Ansel84/BMW_E30_SI_Board/KiCad Projects/BMW E30 VFL SI Board V2/BMW_E30_VFL_SI_Board_Schematic_V2.1.pdf

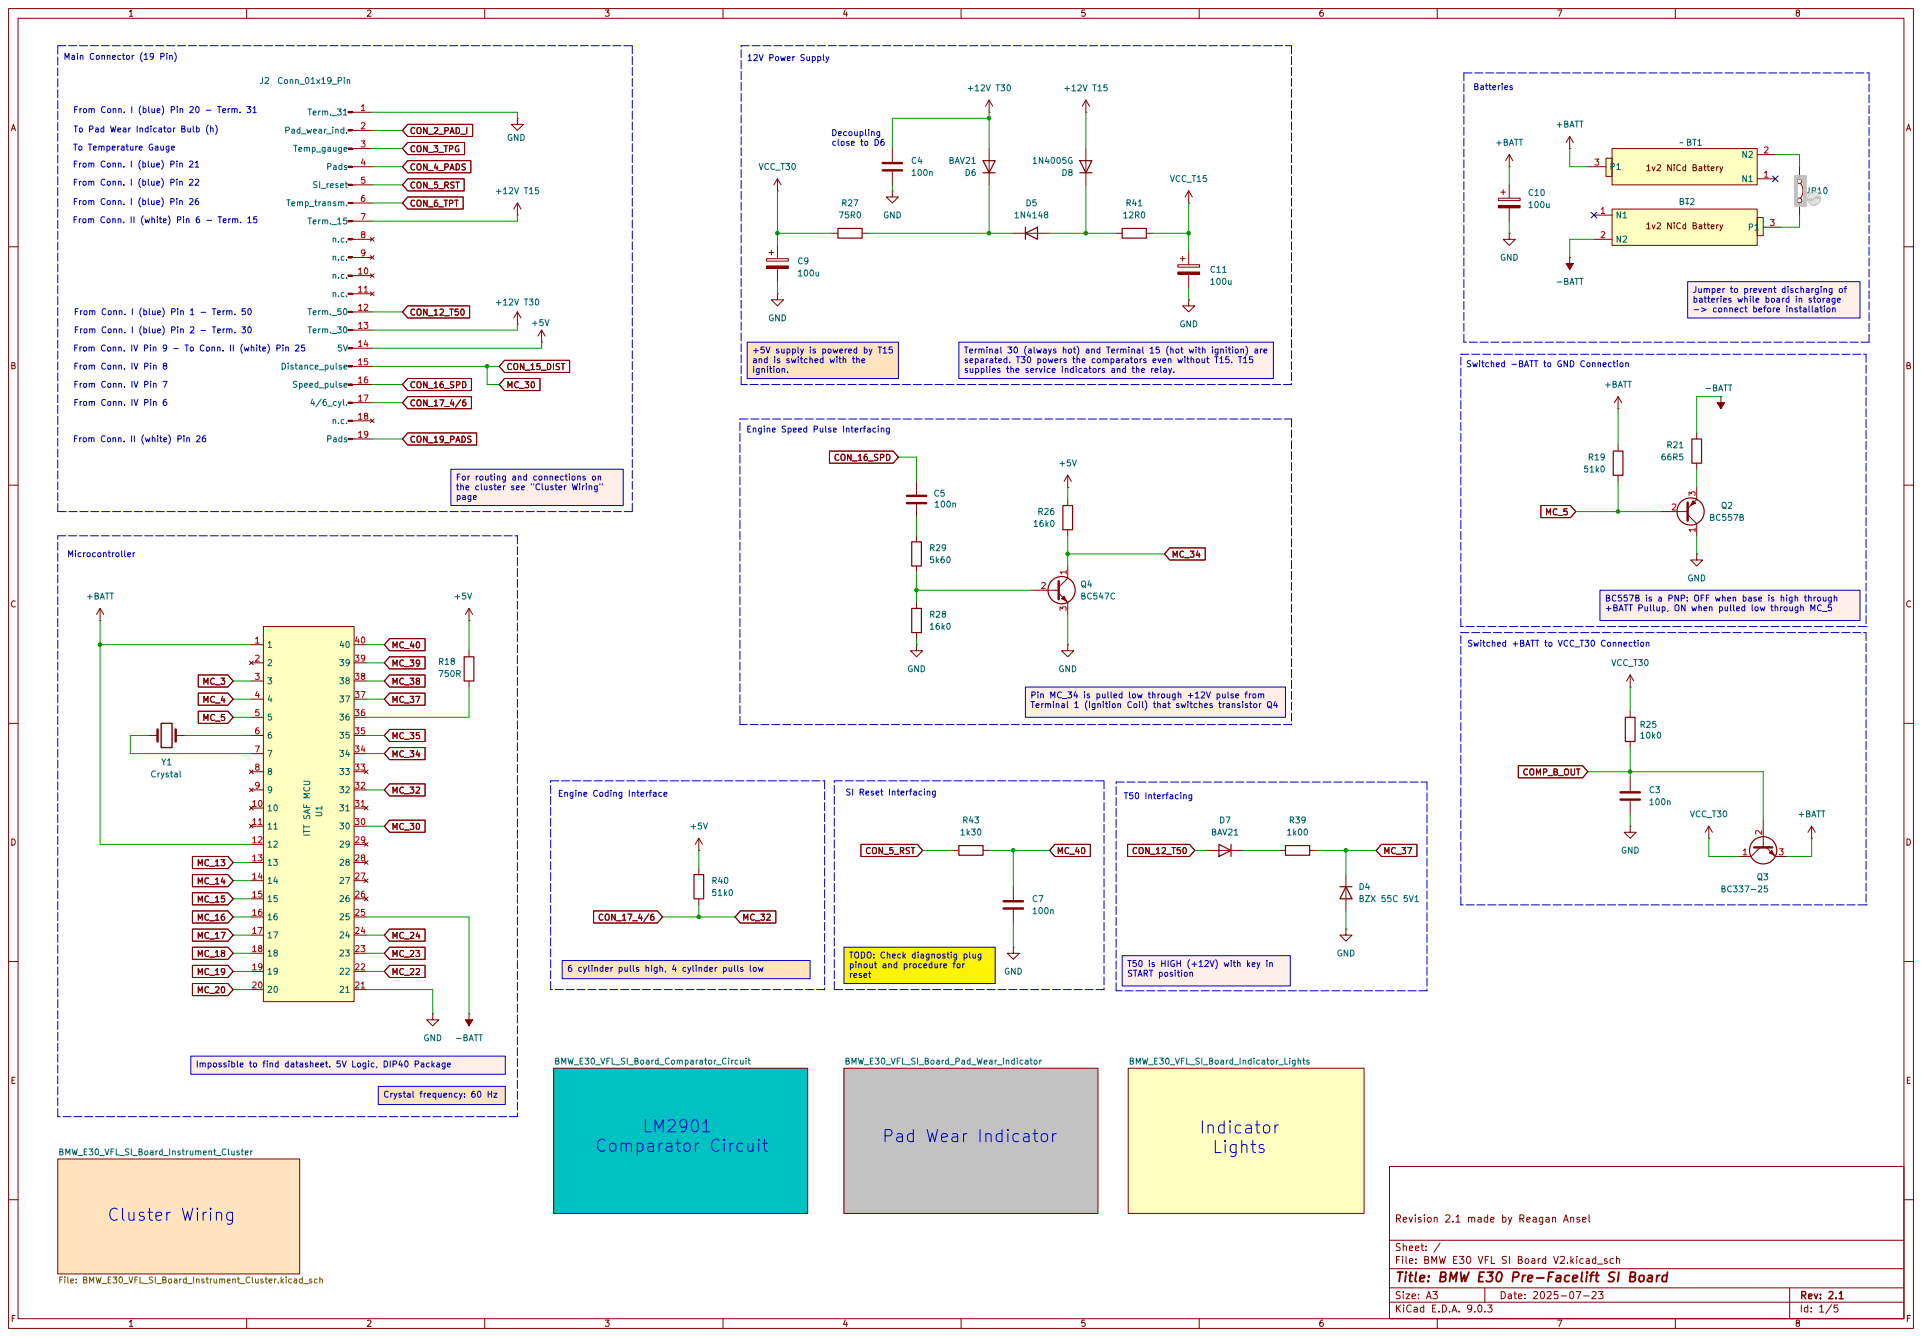
[picture p1: page 1]

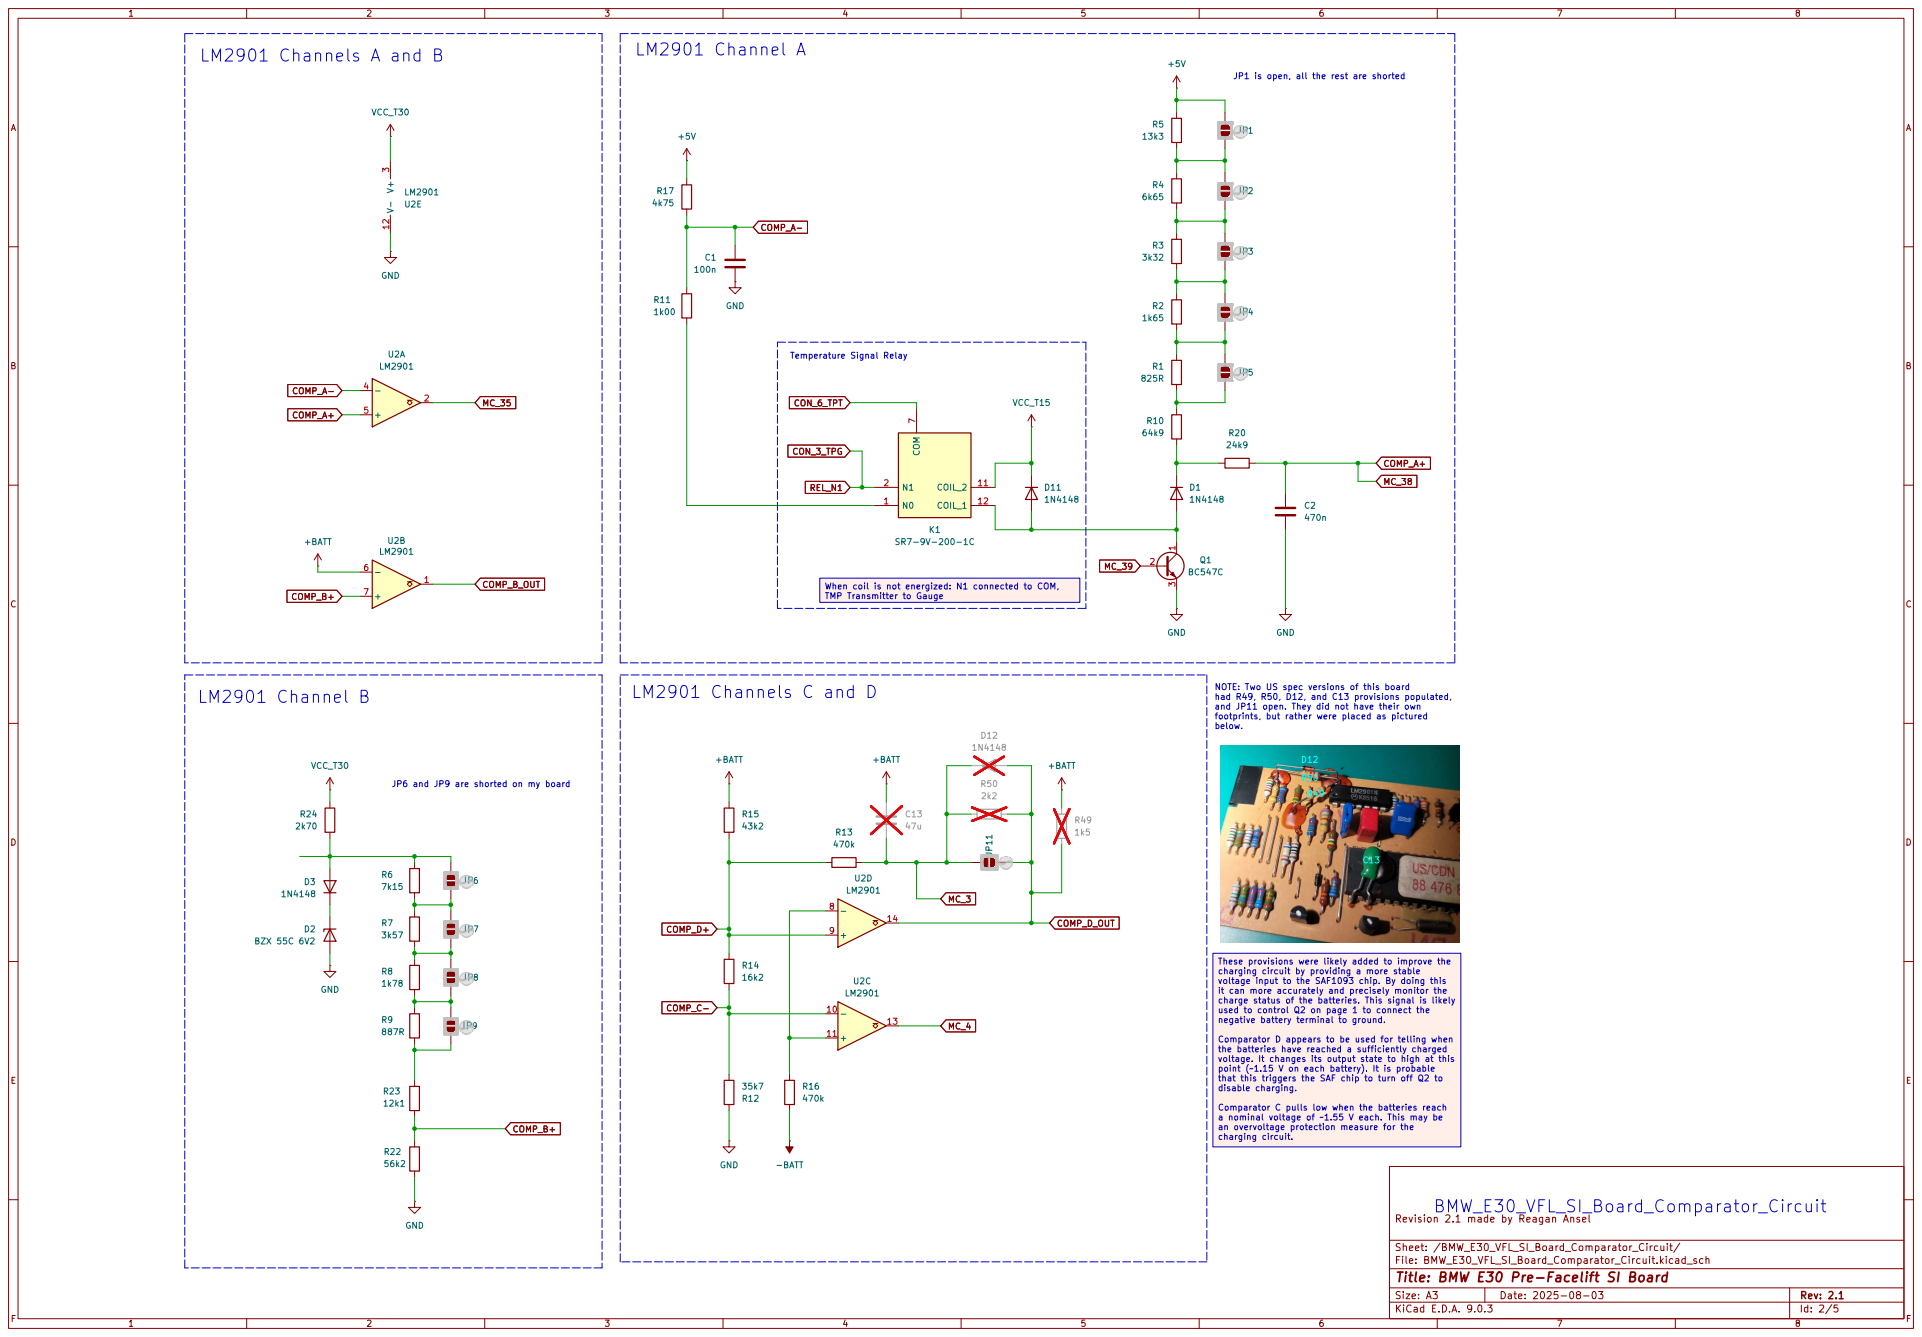
[picture p2: page 2]

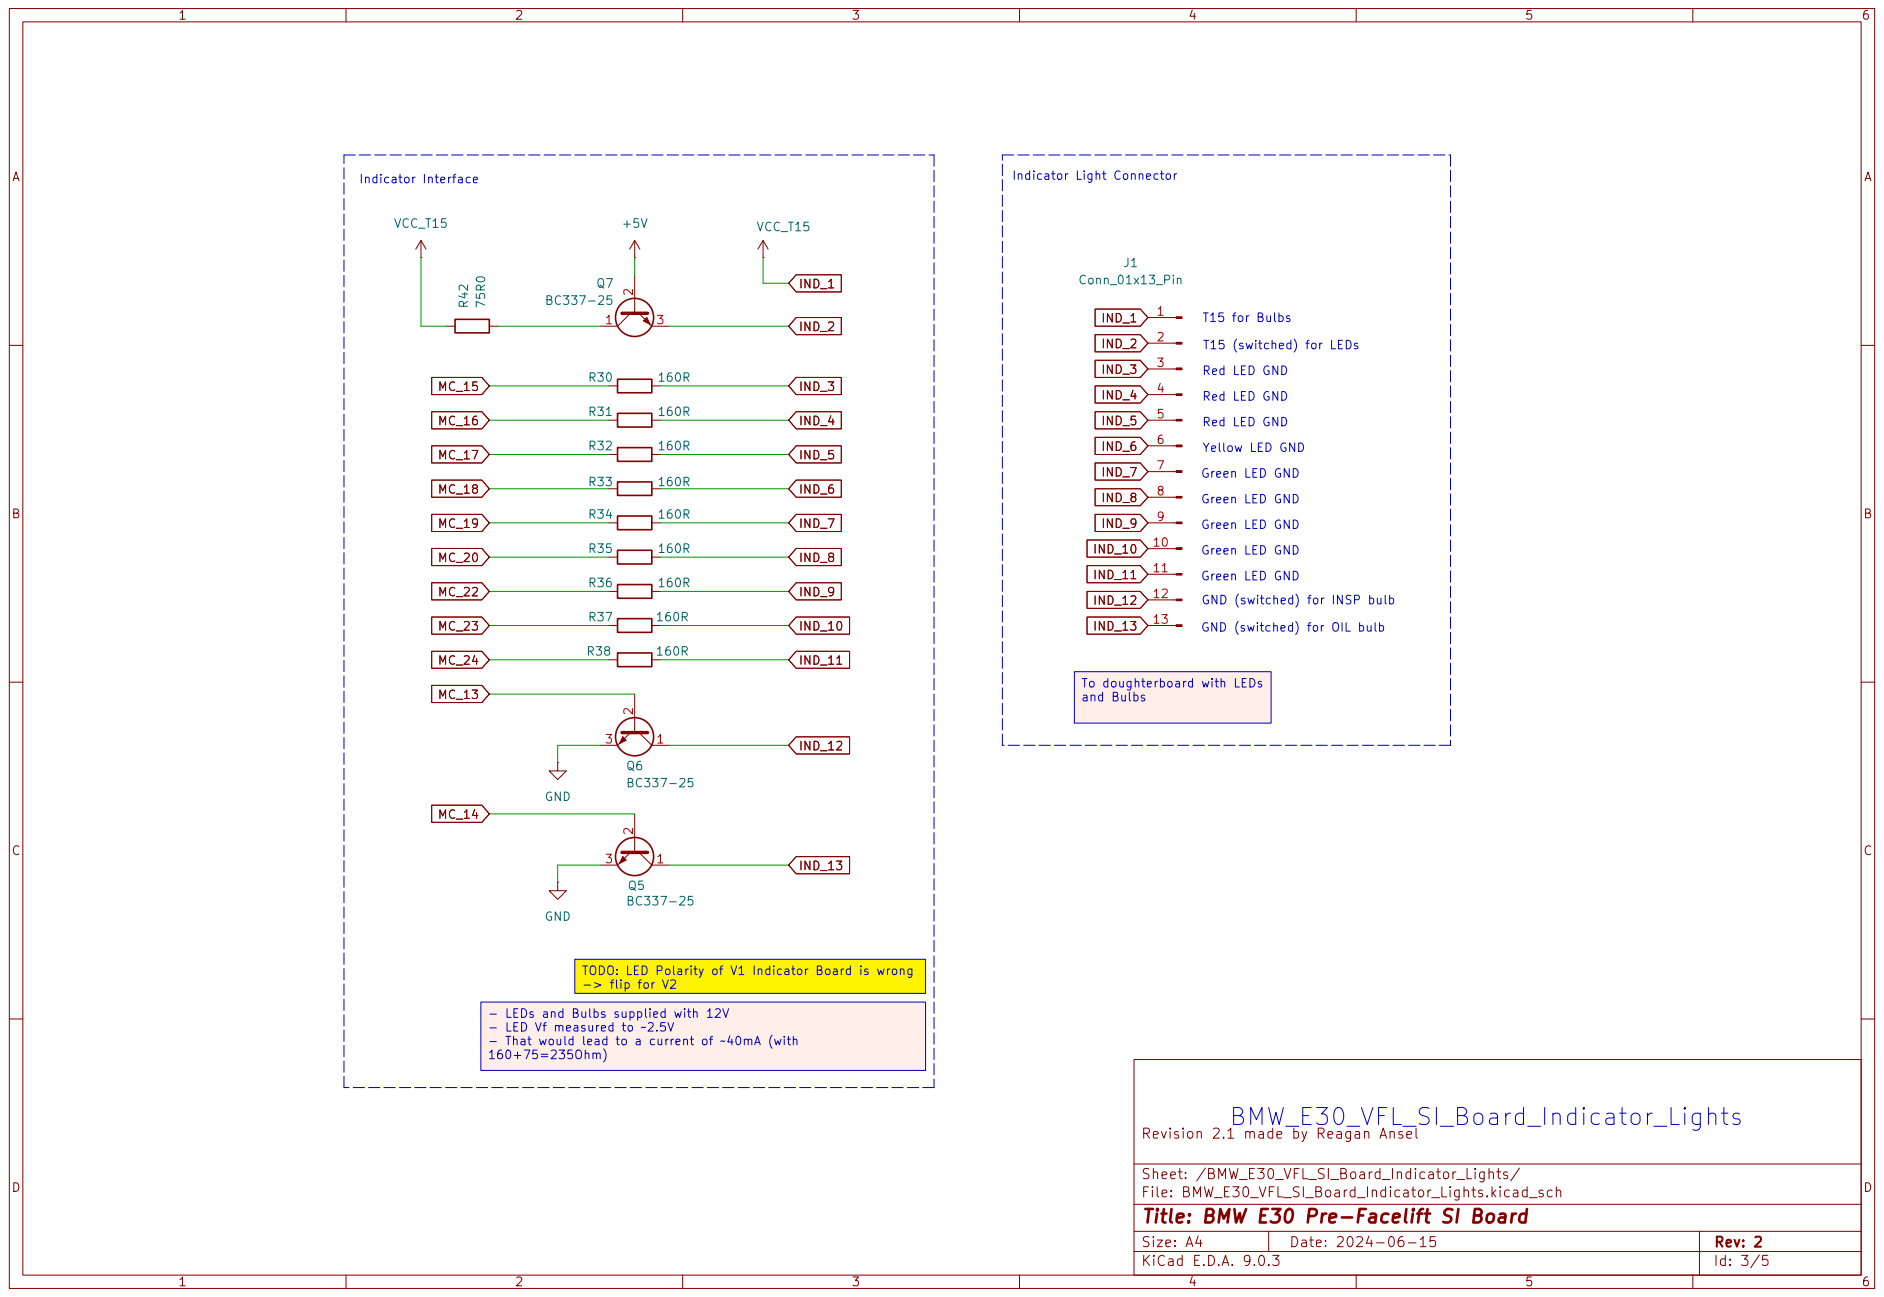
[picture p3: page 3]

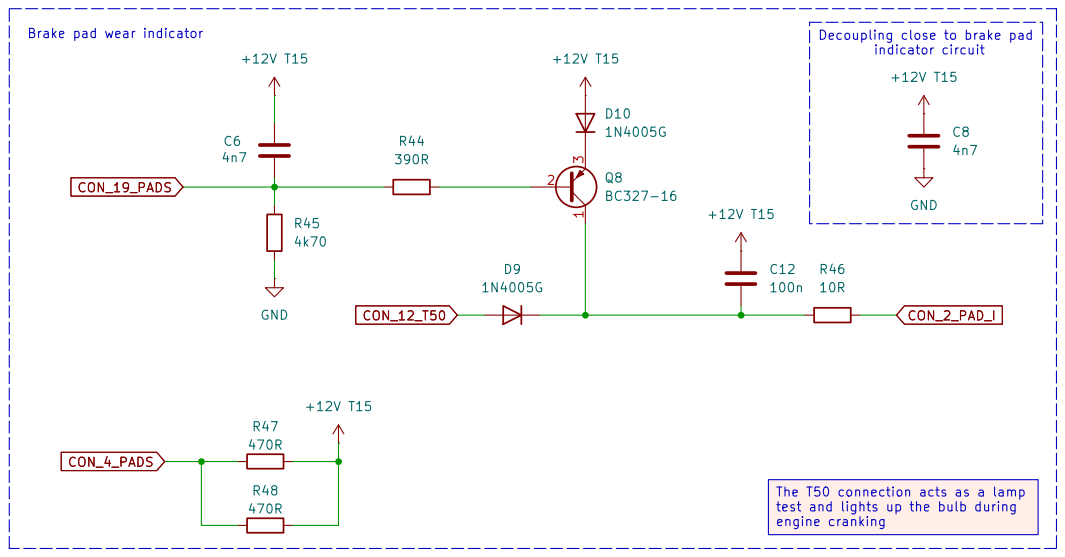
[picture p4: page 4]

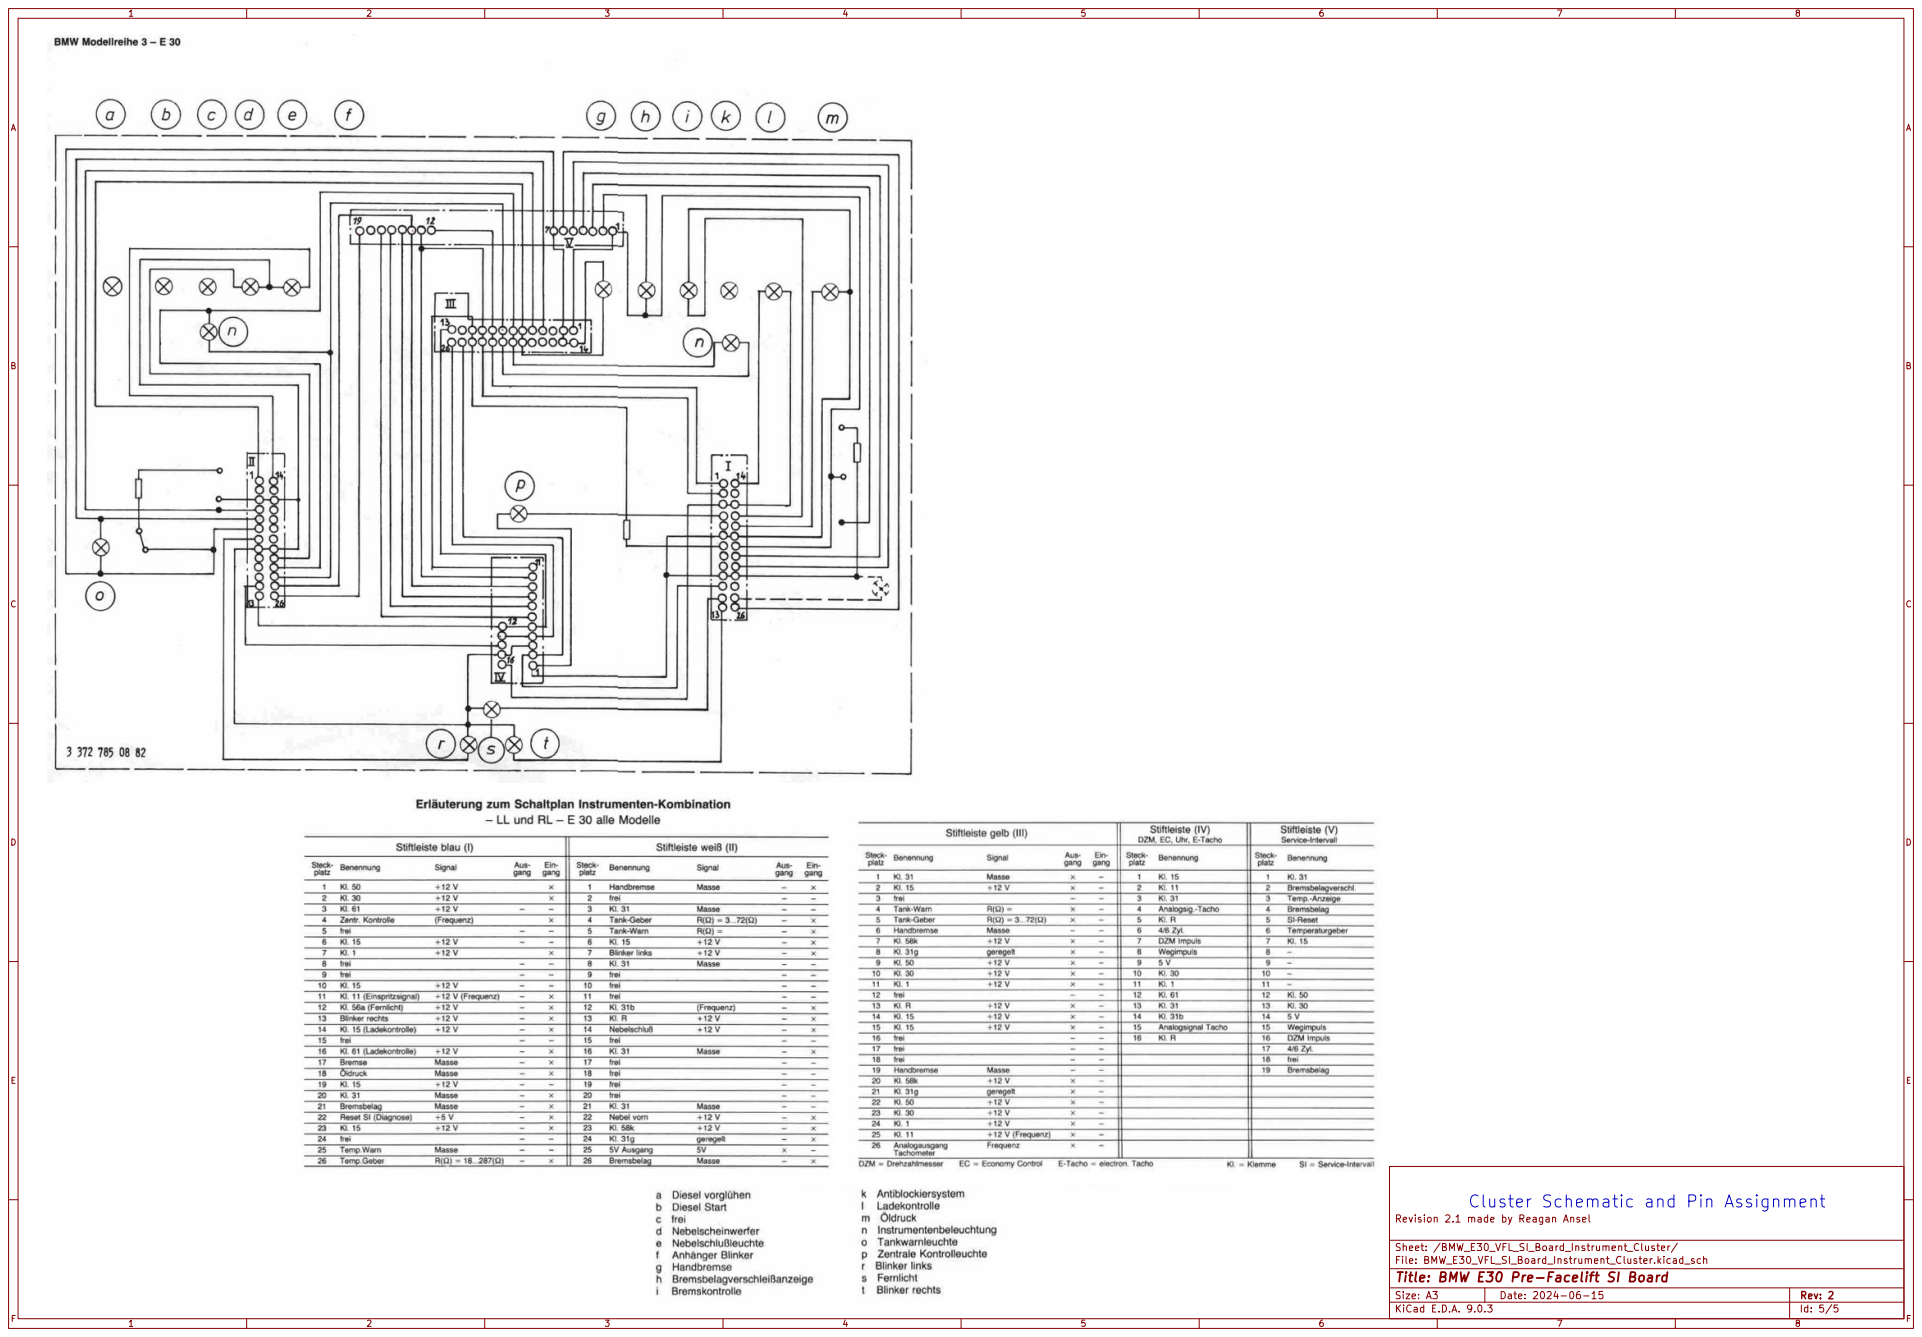
[picture p5: page 5]
