Ansel84/BMW_E30_SI_Board/KiCad Projects/BMW E30 VFL SI Board V2/BMW_E30_VFL_SI_Board_Schematic_V2.pdf

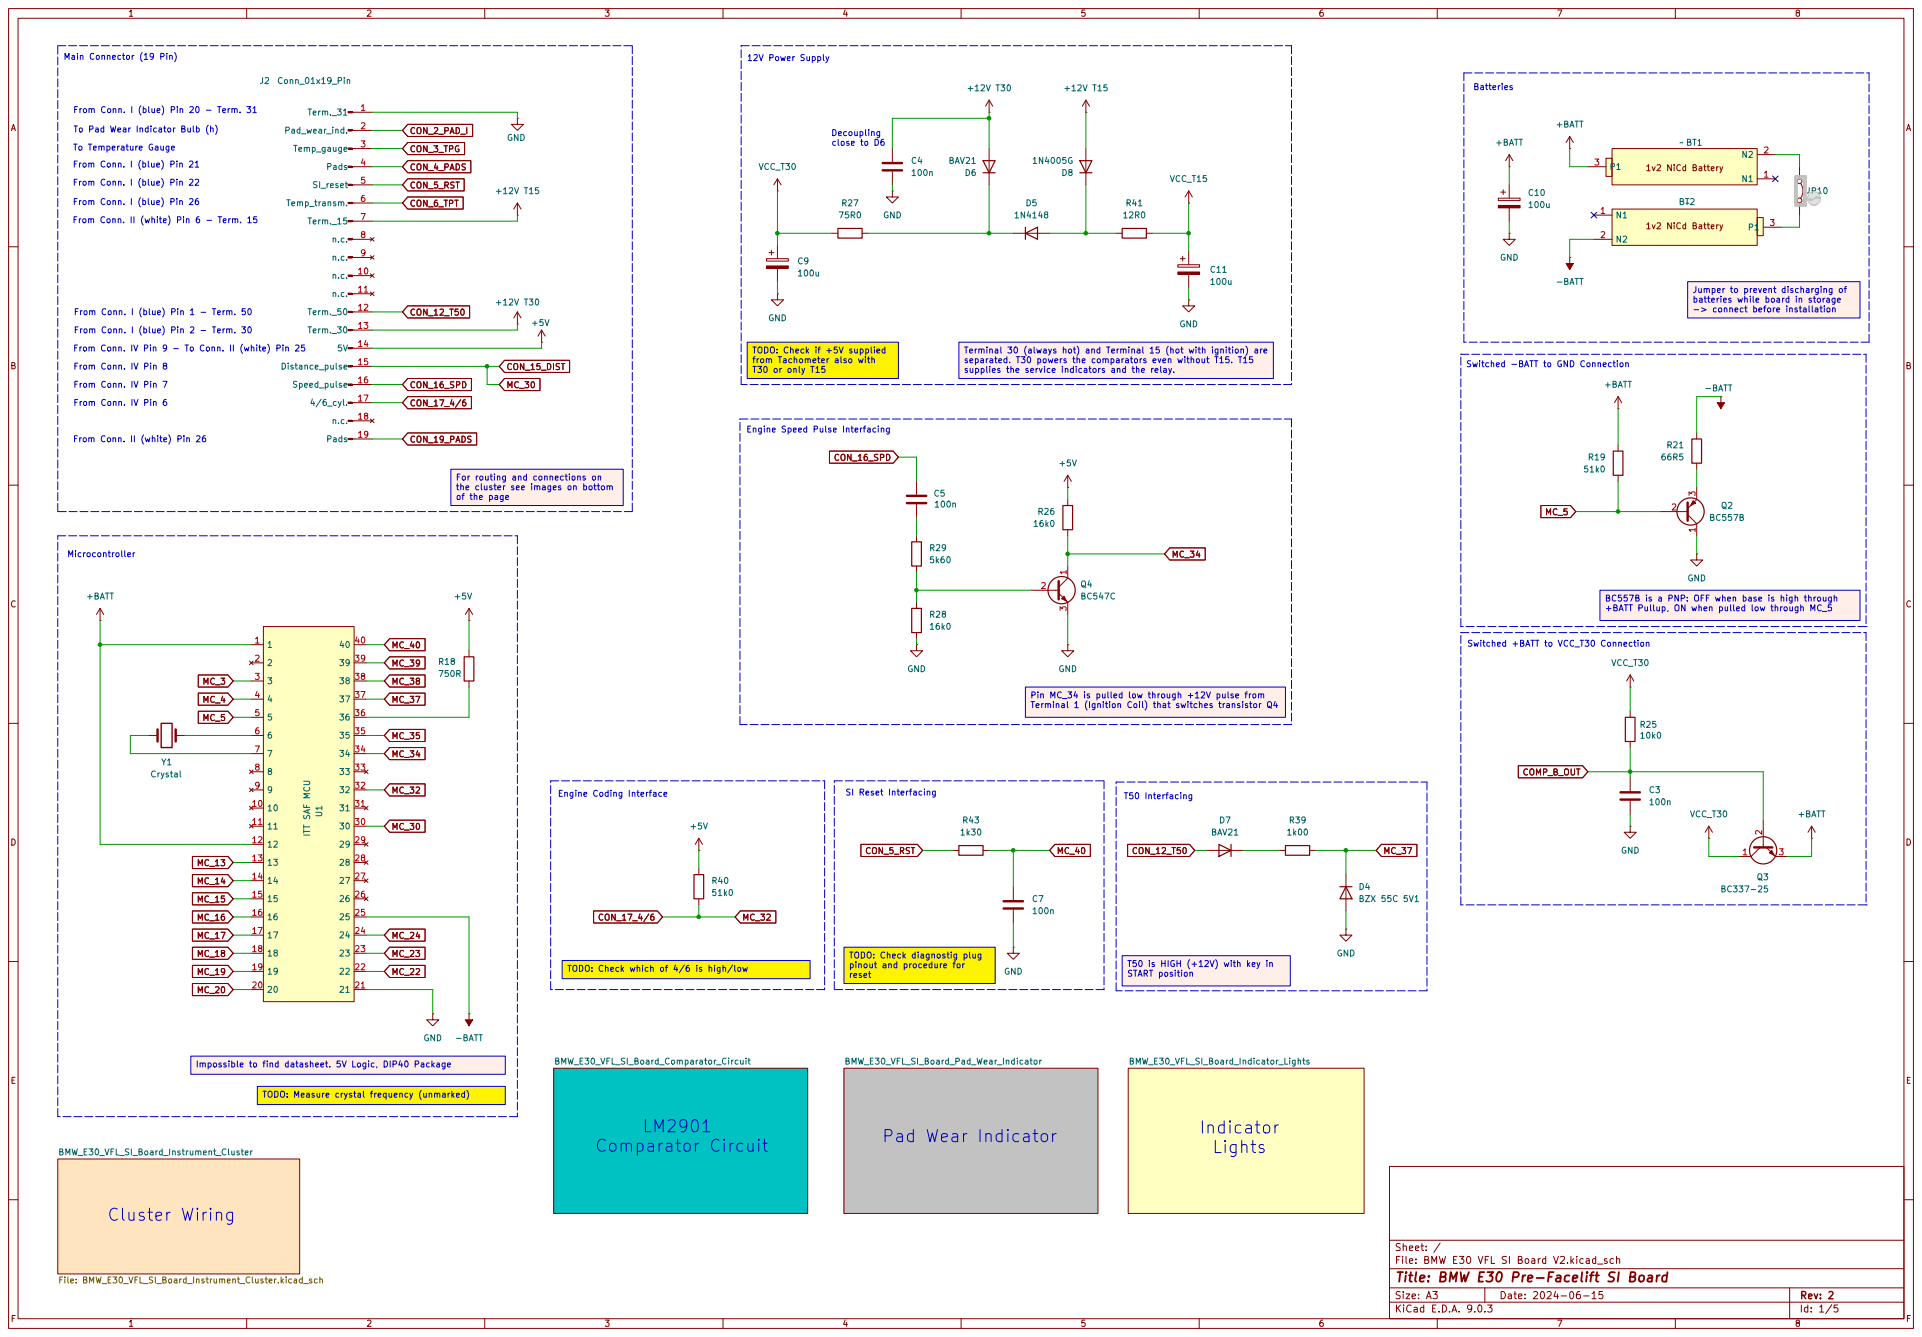
[picture p6: page 1]

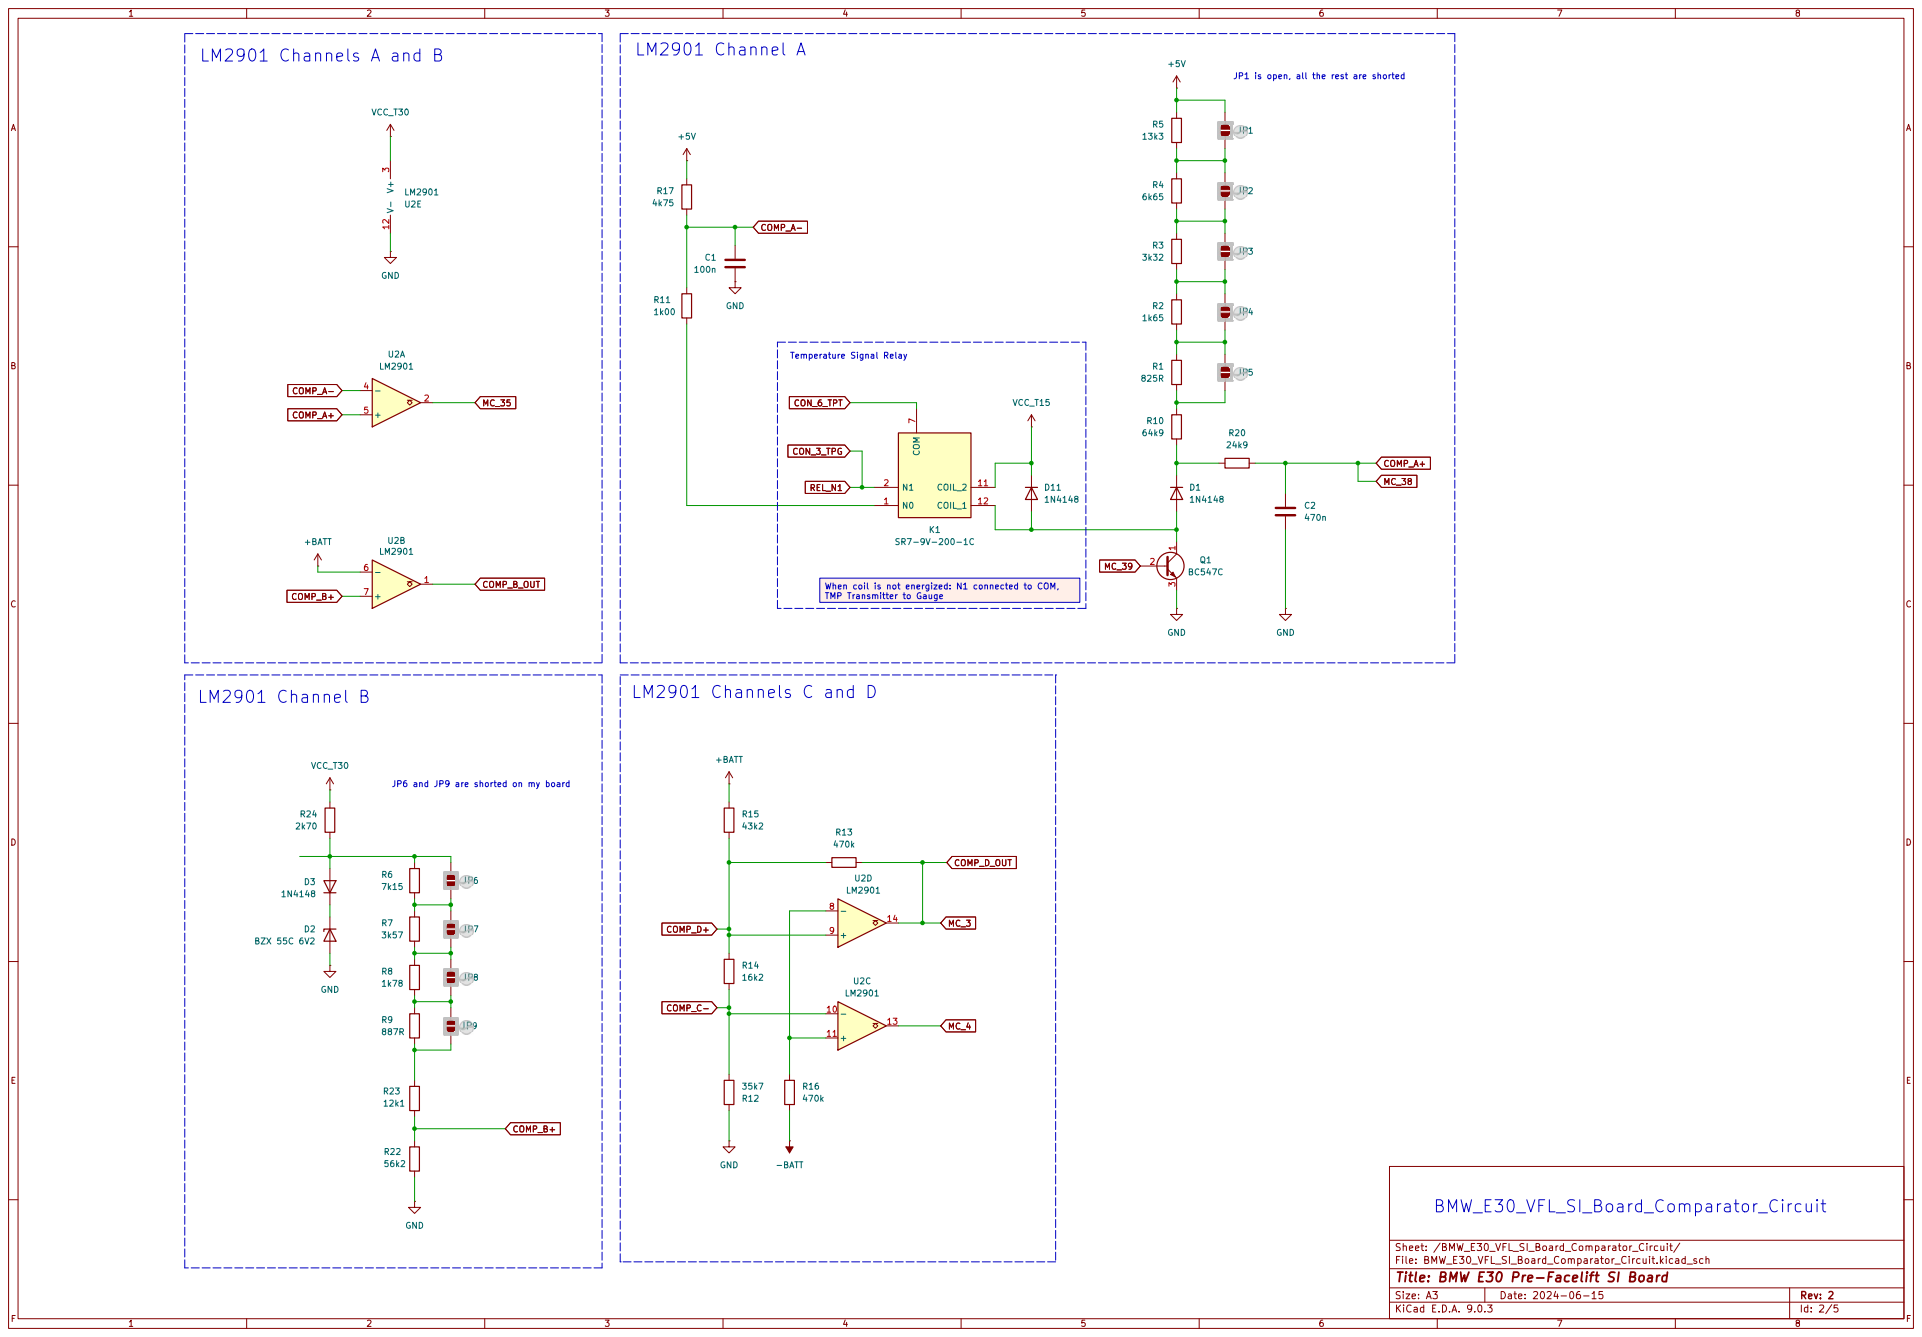
[picture p7: page 2]

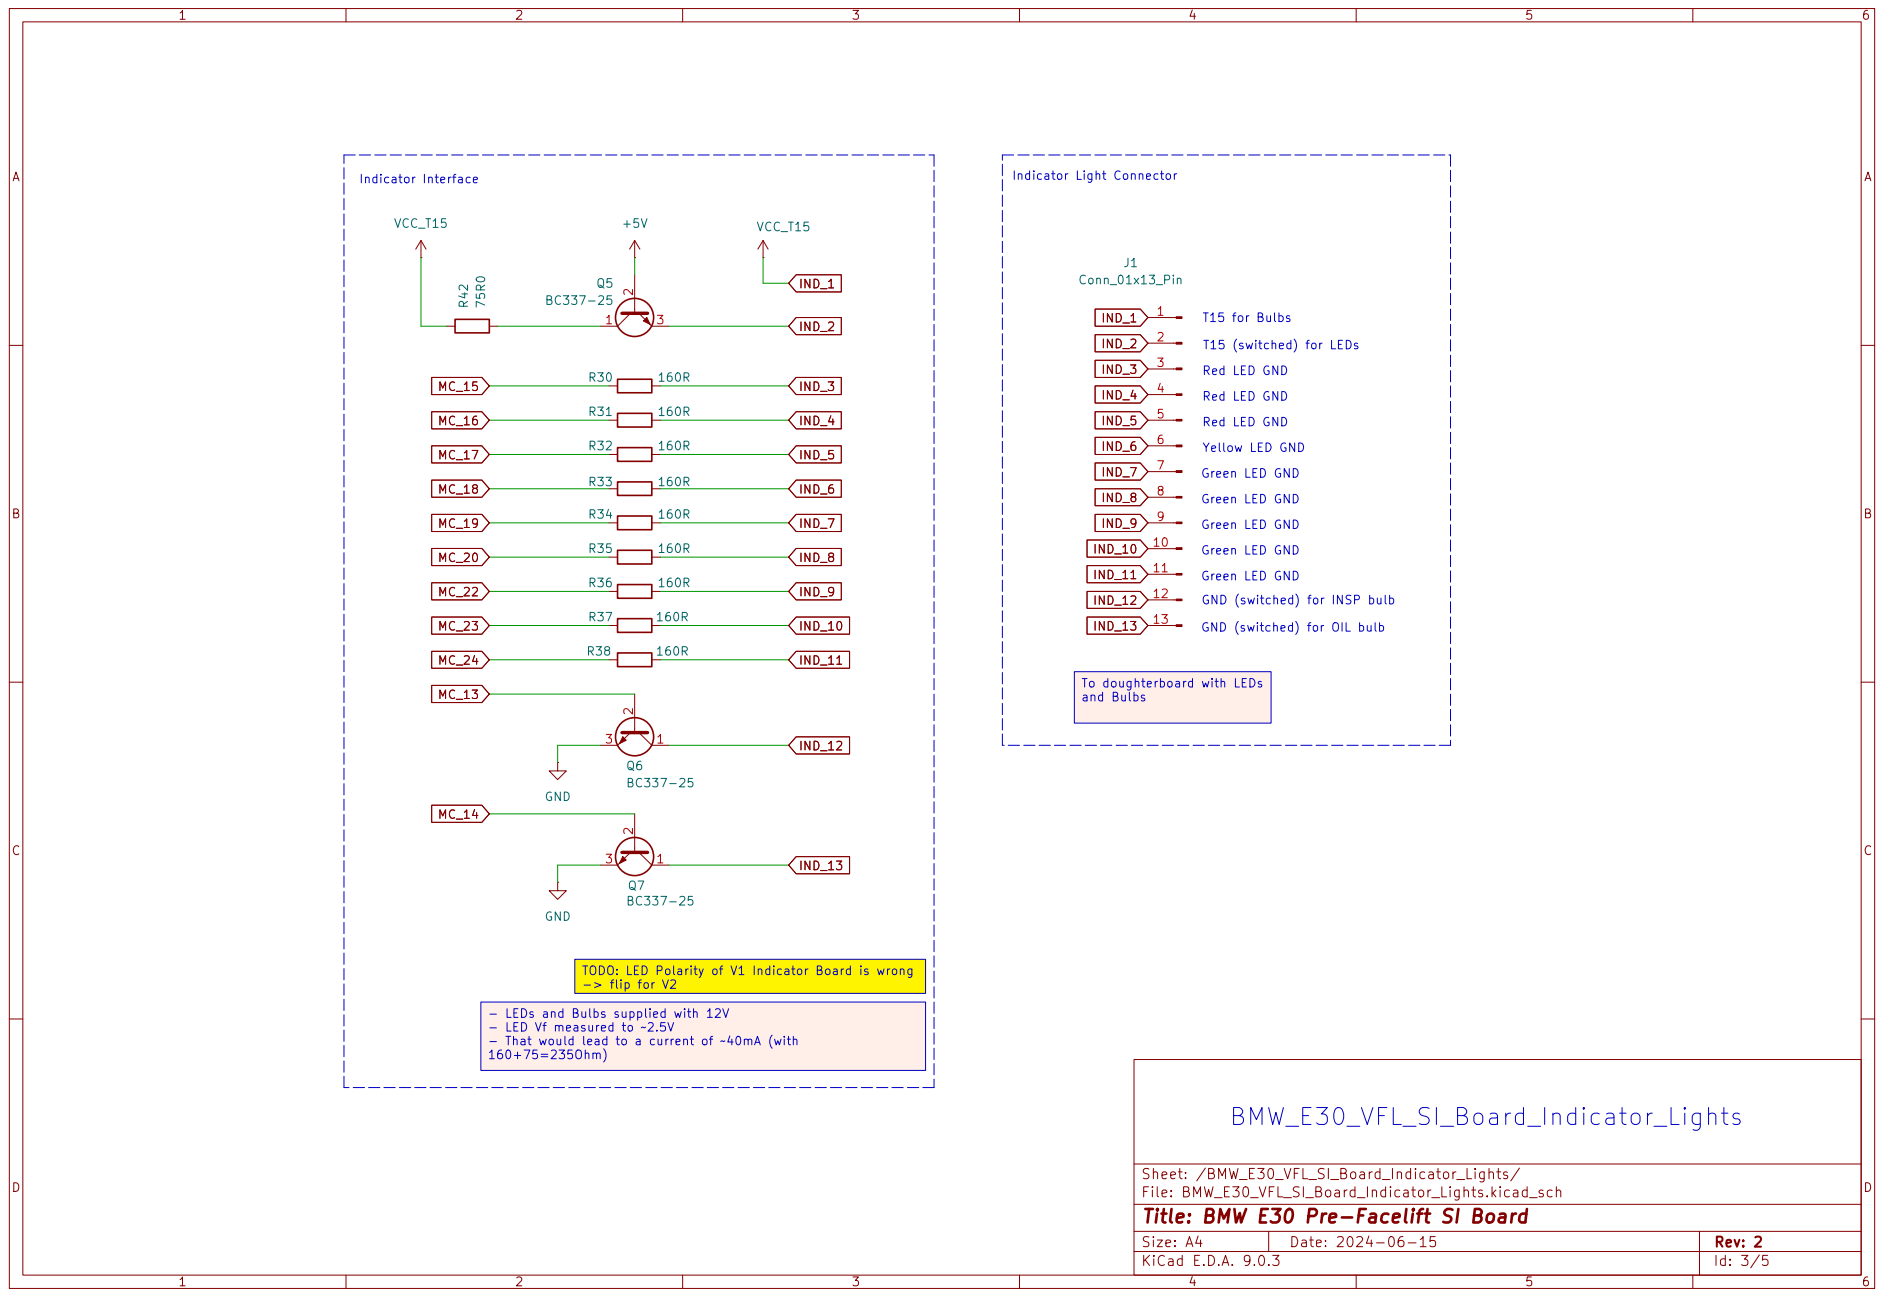
[picture p8: page 3]

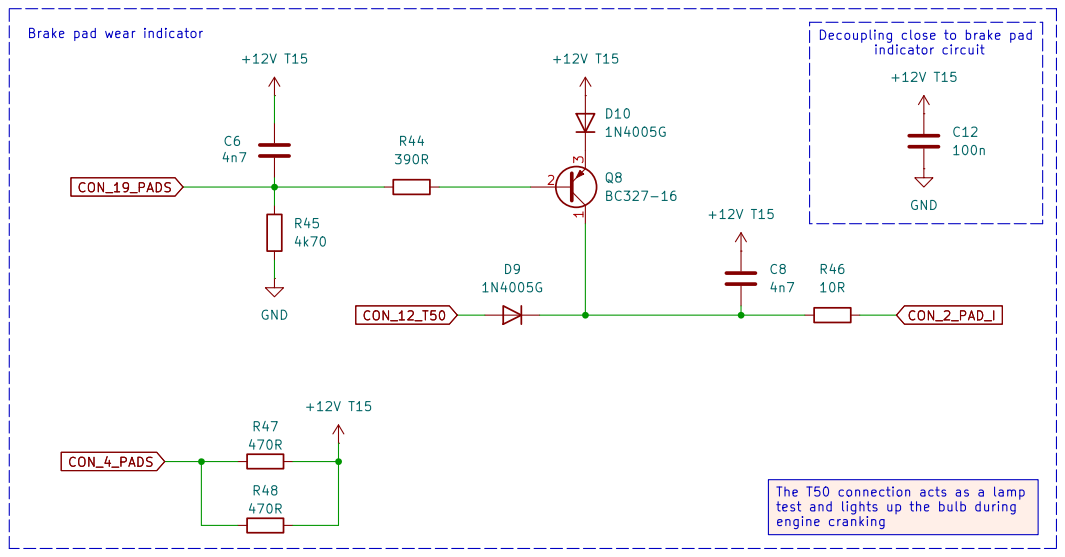
[picture p9: page 4]

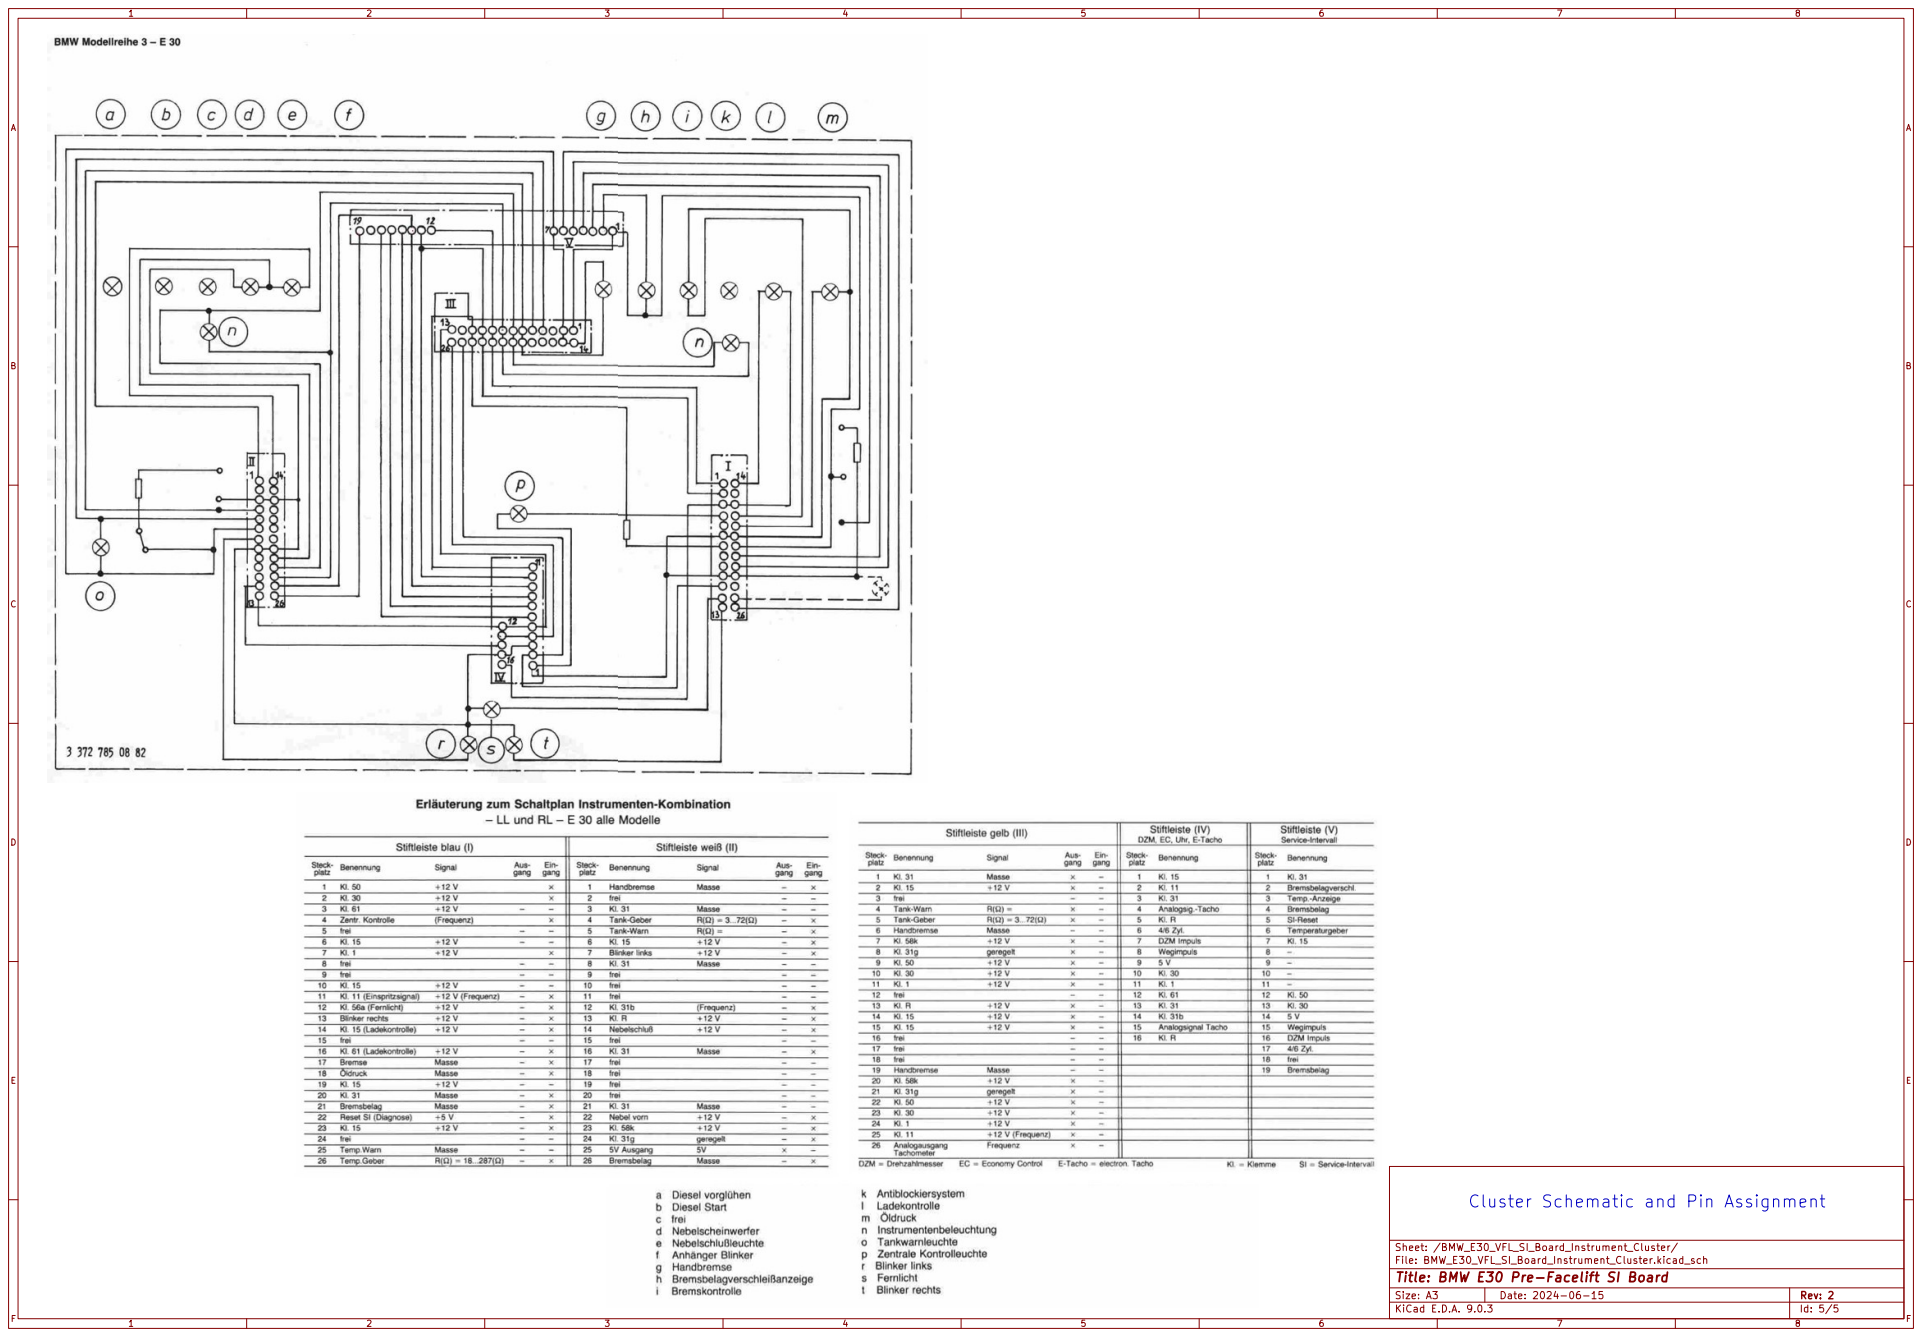
[picture p10: page 5]
