Ansel84/BMW_E30_SI_Board/KiCad Projects/BMW E30 VFL SI Board V2/BMW E30 VFL SI Board V2.kicad_sch

## KiCad design KiCad Projects/BMW E30 VFL SI Board V2/BMW E30 VFL SI Board V2.kicad_sch (2025-11-11)

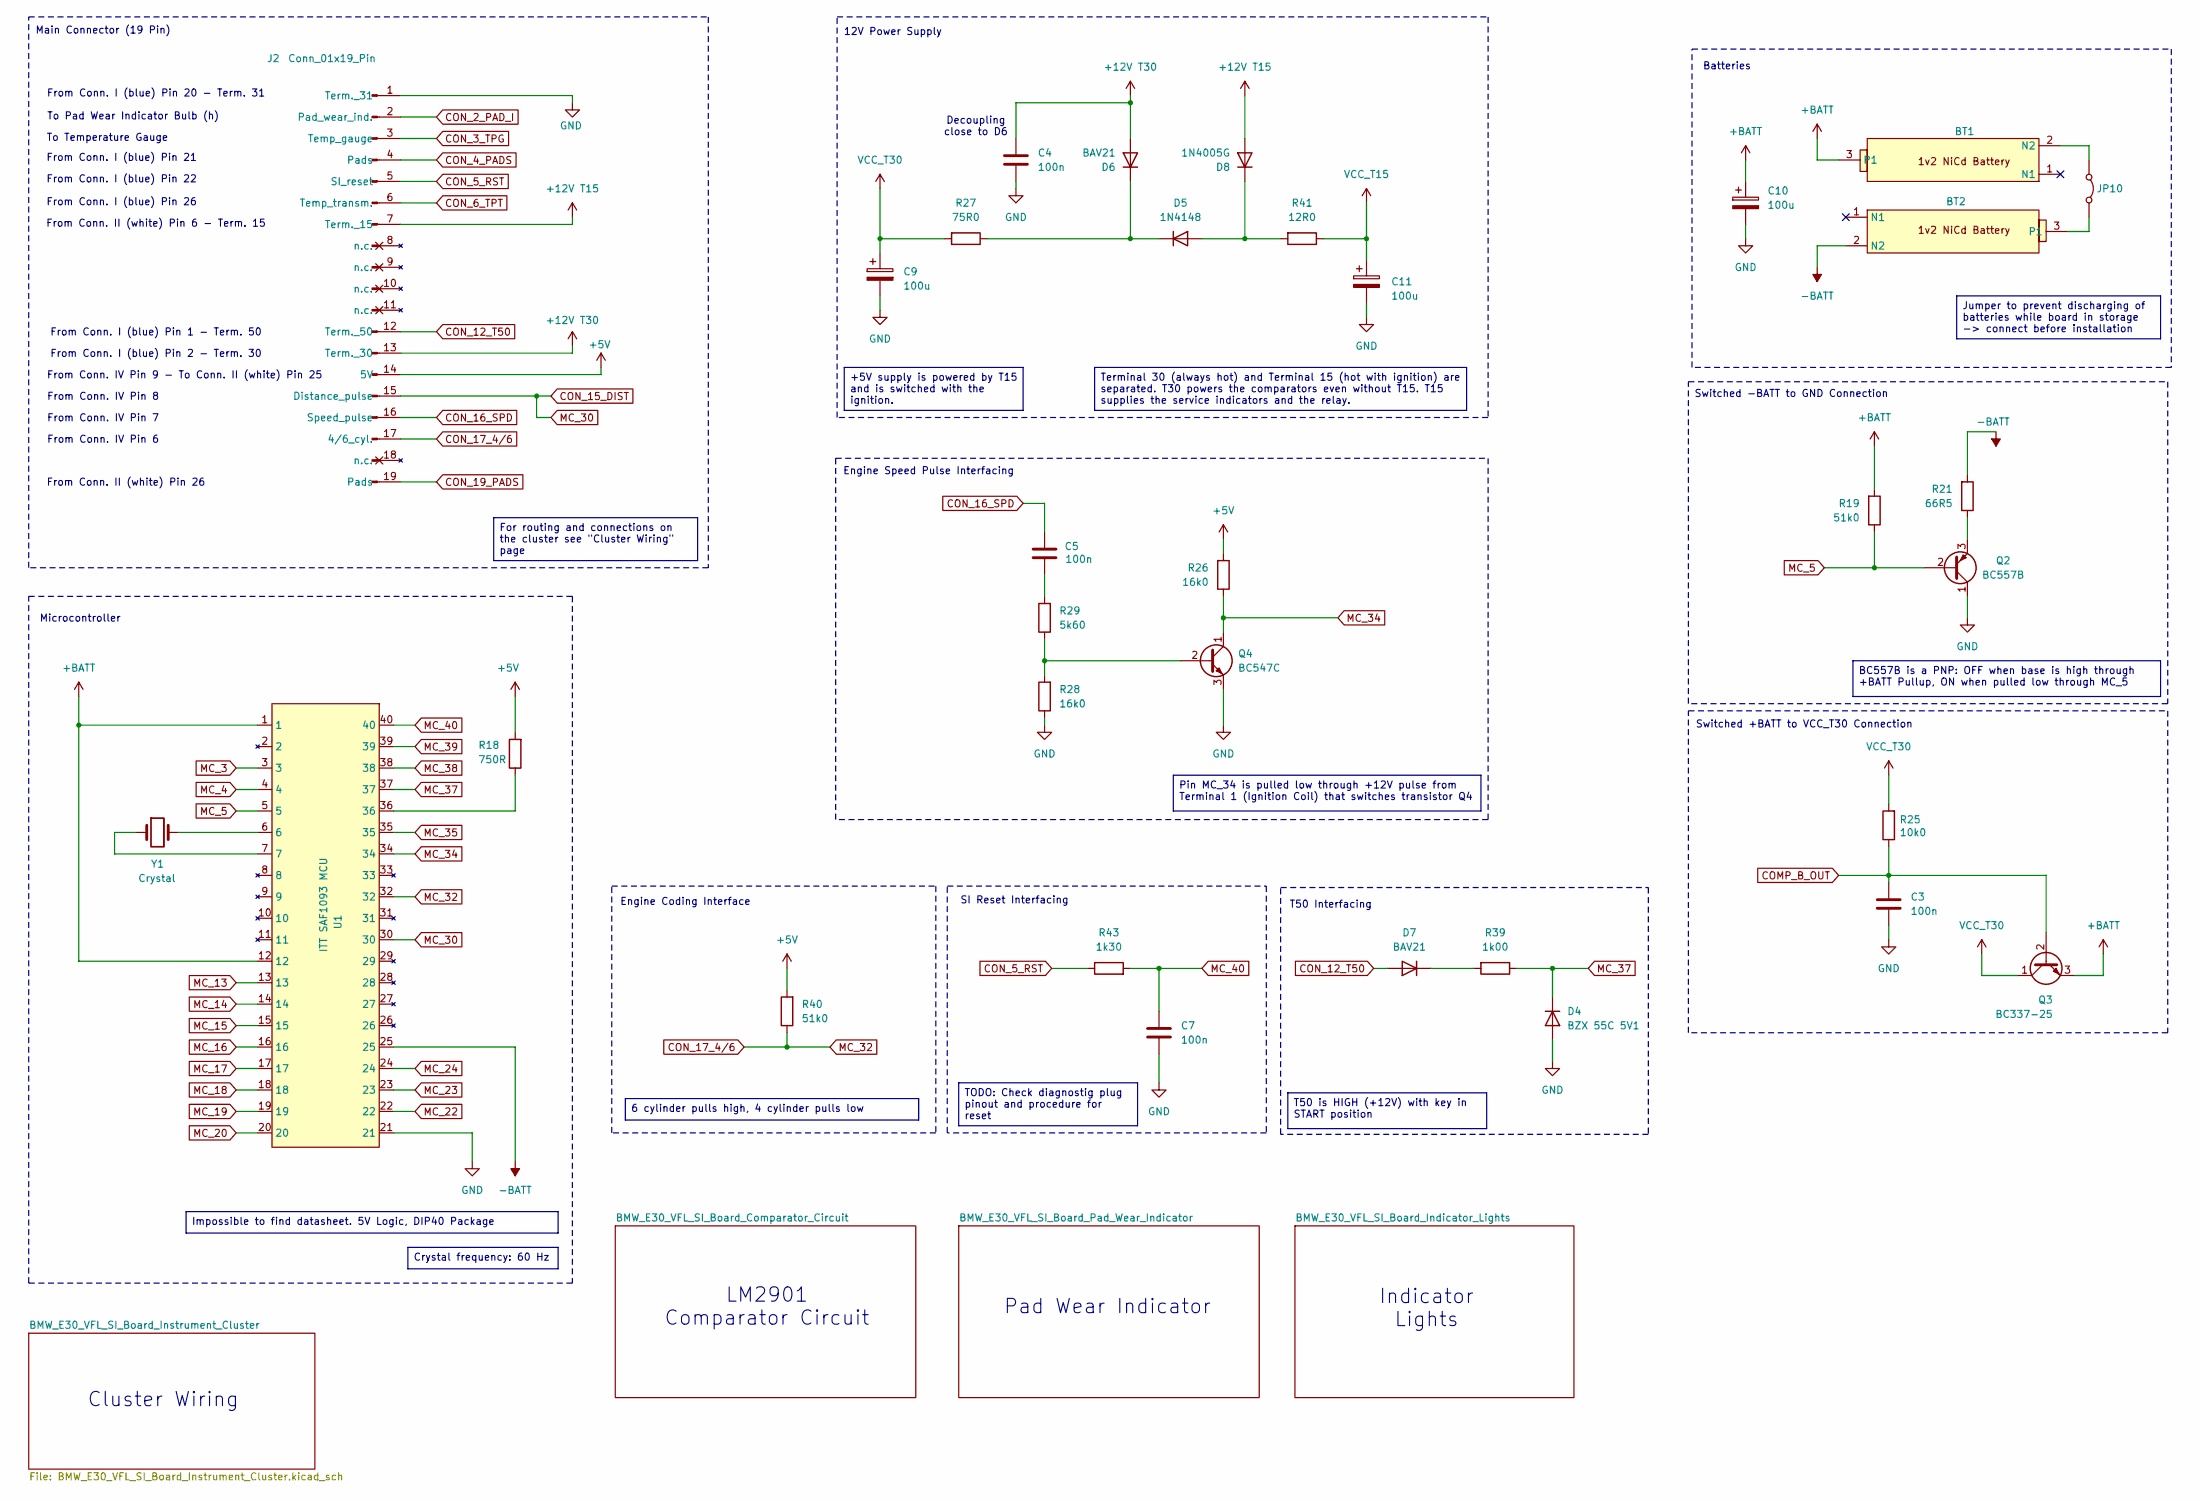
[picture p11: schematic BMW E30 VFL SI Board V2.kicad_sch]

Parts:
BT1, BT2: E30 SI Battery NiCd AA
C3, C4, C7: 100n; C_Rect_L7.0mm_W2.5mm_P5.00mm
C5: 100n; C_Rect_L7.2mm_W2.5mm_P5.00mm_FKS2_FKP2_MKS2_MKP2
C9, C10: 100u; CP_Axial_L16.0mm_D8.5mm_P22.5mm_Horizontal
C11: 100u; CP_Axial_L18.0mm_D8.5mm_P22.5mm_Horizontal
D4: BZX 55C 5V1; D_DO-35_SOD27_P10.16mm_Horizontal
D5: 1N4148; D_DO-35_SOD27_P7.62mm_Horizontal
D6: BAV21; D_DO-35_SOD27_P10.16mm_Horizontal
D7: BAV21; D_DO-35_SOD27_P12.70mm_Horizontal
D8: 1N4005G; D_DO-41_SOD81_P12.70mm_Horizontal
J2: Conn_01x19_Pin; E30_SI_Connector_19Pin_P3.5
JP10: Jumper_2_Bridged; PinHeader_1x02_P2.54mm_Vertical
Q2: BC557B; TO-92_Inline_Wide
Q3: BC337-25; TO-92_Inline_Wide
Q4: BC547C; TO-92_Inline_Wide
R18: 750R; R_Axial_DIN0207_L6.3mm_D2.5mm_P12.70mm_Horizontal
R19, R40: 51k0; R_Axial_DIN0207_L6.3mm_D2.5mm_P10.16mm_Horizontal
R21: 66R5; R_Axial_DIN0207_L6.3mm_D2.5mm_P10.16mm_Horizontal
R25: 10k0; R_Axial_DIN0207_L6.3mm_D2.5mm_P10.16mm_Horizontal
R26: 16k0; R_Axial_DIN0207_L6.3mm_D2.5mm_P20.32mm_Horizontal
R27: 75R0; R_Axial_DIN0207_L6.3mm_D2.5mm_P12.70mm_Horizontal
R28: 16k0; R_Axial_DIN0207_L6.3mm_D2.5mm_P10.16mm_Horizontal
R29: 5k60; R_Axial_DIN0207_L6.3mm_D2.5mm_P10.16mm_Horizontal
R39: 1k00; R_Axial_DIN0207_L6.3mm_D2.5mm_P12.70mm_Horizontal
R41: 12R0; R_Axial_DIN0414_L11.9mm_D4.5mm_P22.86mm_Horizontal
R43: 1k30; R_Axial_DIN0207_L6.3mm_D2.5mm_P10.16mm_Horizontal
U1: ITT SAF1093 MCU; DIP-40_W15.24mm
Y1: Crystal; Crystal_C38-LF_D3.0mm_L8.0mm_Horizontal

Connections:
+5V: J2.14 (5V), R18.2, R26.2, R40.2
+12V T15: D8.2 (A), J2.7 (Term._15)
+12V T30: C4.2, D6.2 (A), J2.13 (Term._30)
+BATT: BT1.3 (P1), C10.1, Q3.3 (E), R19.2, U1.1, U1.12
-BATT: BT2.2 (N2), R21.2, U1.25
COMP_B_OUT: C3.2, Q3.2 (B), R25.1
CON_2_PAD_I: J2.2 (Pad_wear_ind.)
CON_3_TPG: J2.3 (Temp_gauge)
CON_4_PADS: J2.4 (Pads)
CON_5_RST: J2.5 (SI_reset), R43.1
CON_6_TPT: J2.6 (Temp_transm.)
CON_12_T50: D7.2 (A), J2.12 (Term._50)
CON_15_DIST: J2.15 (Distance_pulse), U1.30
CON_16_SPD: C5.2, J2.16 (Speed_pulse)
CON_17_4/6: J2.17 (4/6_cyl.), R40.1, U1.32
CON_19_PADS: J2.19 (Pads)
GND: C3.1, C4.1, C7.2, C9.2, C10.2, C11.2, D4.2 (A), J2.1 (Term._31), Q2.1 (C), Q4.3 (E), R28.1, U1.21
MC_3: U1.3
MC_4: U1.4
MC_5: Q2.2 (B), R19.1, U1.5
MC_13: U1.13
MC_14: U1.14
MC_15: U1.15
MC_16: U1.16
MC_17: U1.17
MC_18: U1.18
MC_19: U1.19
MC_20: U1.20
MC_22: U1.22
MC_23: U1.23
MC_24: U1.24
MC_34: Q4.1 (C), R26.1, U1.34
MC_35: U1.35
MC_37: D4.1 (K), R39.1, U1.37
MC_38: U1.38
MC_39: U1.39
MC_40: C7.1, R43.2, U1.40
unnamed: BT1.2 (N2), JP10.1 (A)
unnamed: BT2.3 (P1), JP10.2 (B)
unnamed: C5.1, R29.2
unnamed: D5.1 (K), D6.1 (K), R27.1
unnamed: D5.2 (A), D8.1 (K), R41.2
unnamed: D7.1 (K), R39.2
unnamed: Q2.3 (E), R21.1
unnamed: Q4.2 (B), R28.2, R29.1
unnamed: R18.1, U1.36
unnamed: U1.6, Y1.2
unnamed: U1.7, Y1.1
VCC_T15: C11.1, R41.1
VCC_T30: C9.1, Q3.1 (C), R25.2, R27.2

Notes on the sheet:
Switched +BATT to VCC_T30 Connection
Engine Speed Pulse Interfacing
Decoupling close to D6
From Conn. I (blue) Pin 1 - Term. 50
From Conn. I (blue) Pin 20 - Term. 31
From Conn. I (blue) Pin 2 - Term. 30
Microcontroller
Cluster Wiring
From Conn. I (blue) Pin 21
From Conn. IV Pin 8
From Conn. II (white) Pin 6 - Term. 15
To Pad Wear Indicator Bulb (h)
12V Power Supply
From Conn. I (blue) Pin 26
From Conn. IV Pin 7
Main Connector (19 Pin)
SI Reset Interfacing
From Conn. I (blue) Pin 22
Indicator Lights
LM2901 Comparator Circuit
From Conn. IV Pin 9 - To Conn. II (white) Pin 25
T50 Interfacing
Engine Coding Interface
From Conn. IV Pin 6
To Temperature Gauge
Pad Wear Indicator
Switched -BATT to GND Connection
Batteries
From Conn. II (white) Pin 26
Crystal frequency: 60 Hz
Terminal 30 (always hot) and Terminal 15 (hot with ignition) are separated. T30 powers the comparators even without T15. T15 supplies the service indicators and the relay.
TODO: Check diagnostig plug pinout and procedure for reset
BC557B is a PNP: OFF when base is high through +BATT Pullup, ON when pulled low through MC_5
T50 is HIGH (+12V) with key in START position
Pin MC_34 is pulled low through +12V pulse from Terminal 1 (Ignition Coil) that switches transistor Q4
+5V supply is powered by T15 and is switched with the ignition.
6 cylinder pulls high, 4 cylinder pulls low
For routing and connections on the cluster see "Cluster Wiring" page
Jumper to prevent discharging of batteries while board in storage -> connect before installation
Impossible to find datasheet. 5V Logic, DIP40 Package
