Ansel84/BMW_E30_SI_Board/KiCad Projects/BMW E30 VFL SI Board V2/BMW_E30_VFL_SI_Board_Comparator_Circuit.kicad_sch

## KiCad design KiCad Projects/BMW E30 VFL SI Board V2/BMW_E30_VFL_SI_Board_Comparator_Circuit.kicad_sch (2025-11-11)

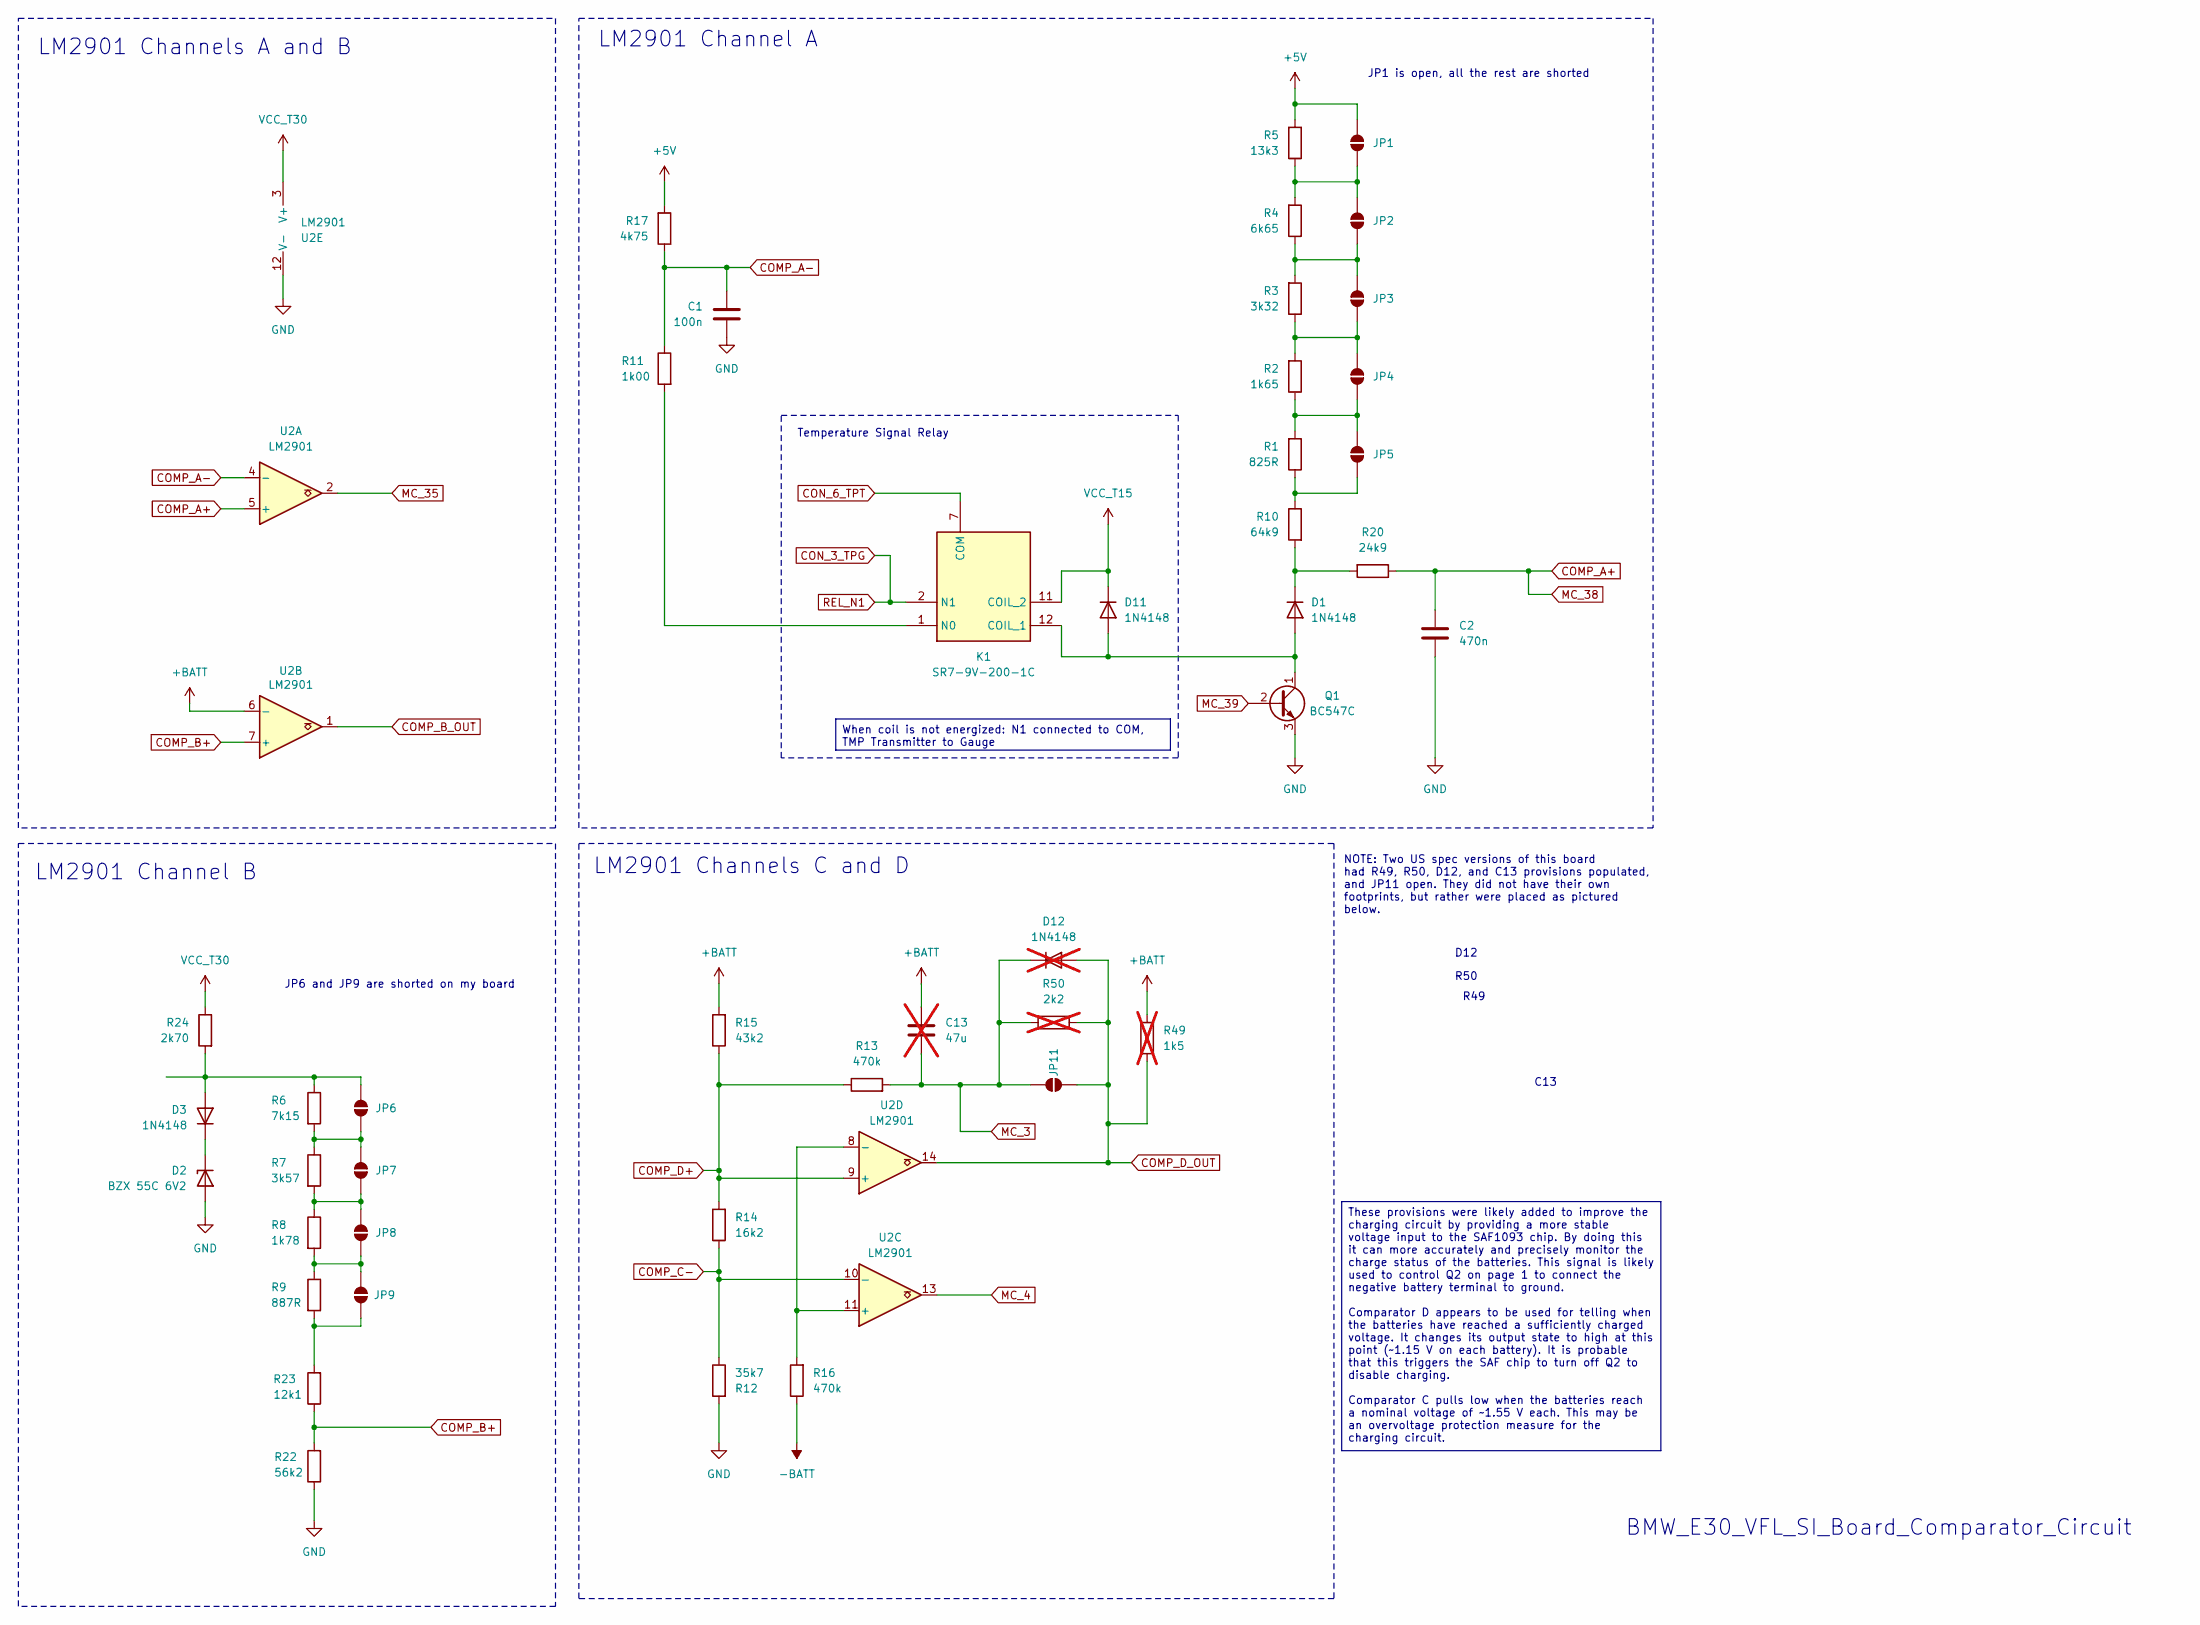
[picture p12: schematic BMW_E30_VFL_SI_Board_Comparator_Circuit.kicad_sch]

Parts:
C1: 100n; C_Rect_L7.0mm_W2.5mm_P5.00mm
C2: 470n; C_Rect_L7.2mm_W5.5mm_P5.00mm_FKS2_FKP2_MKS2_MKP2
C13: 47u; not fitted
D1, D3, D11: 1N4148; D_DO-35_SOD27_P10.16mm_Horizontal
D2: BZX 55C 6V2; D_DO-35_SOD27_P10.16mm_Horizontal
D12: 1N4148; not fitted
JP1, JP2, JP3, JP4, JP5, JP6, JP7, JP8, JP9, JP11: SolderJumper_2_Open; SolderJumper-2_P1.3mm_Open_Pad1.0x1.5mm
K1: SR7-9V-200-1C; SR79V2001C; Mouser Part Number 179-SR7-9V-200-1C
Q1: BC547C; TO-92_Inline_Wide
R1: 825R; R_Axial_DIN0207_L6.3mm_D2.5mm_P10.16mm_Horizontal
R2: 1k65; R_Axial_DIN0207_L6.3mm_D2.5mm_P10.16mm_Horizontal
R3: 3k32; R_Axial_DIN0207_L6.3mm_D2.5mm_P10.16mm_Horizontal
R4: 6k65; R_Axial_DIN0207_L6.3mm_D2.5mm_P10.16mm_Horizontal
R5: 13k3; R_Axial_DIN0207_L6.3mm_D2.5mm_P10.16mm_Horizontal
R6: 7k15; R_Axial_DIN0207_L6.3mm_D2.5mm_P10.16mm_Horizontal
R7: 3k57; R_Axial_DIN0207_L6.3mm_D2.5mm_P10.16mm_Horizontal
R8: 1k78; R_Axial_DIN0207_L6.3mm_D2.5mm_P10.16mm_Horizontal
R9: 887R; R_Axial_DIN0207_L6.3mm_D2.5mm_P10.16mm_Horizontal
R10: 64k9; R_Axial_DIN0207_L6.3mm_D2.5mm_P12.70mm_Horizontal
R11: 1k00; R_Axial_DIN0207_L6.3mm_D2.5mm_P17.78mm_Horizontal
R12: 35k7; R_Axial_DIN0207_L6.3mm_D2.5mm_P10.16mm_Horizontal
R13, R16: 470k; R_Axial_DIN0207_L6.3mm_D2.5mm_P10.16mm_Horizontal
R14: 16k2; R_Axial_DIN0207_L6.3mm_D2.5mm_P10.16mm_Horizontal
R15: 43k2; R_Axial_DIN0207_L6.3mm_D2.5mm_P10.16mm_Horizontal
R17: 4k75; R_Axial_DIN0207_L6.3mm_D2.5mm_P10.16mm_Horizontal
R20: 24k9; R_Axial_DIN0207_L6.3mm_D2.5mm_P15.24mm_Horizontal
R22: 56k2; R_Axial_DIN0207_L6.3mm_D2.5mm_P10.16mm_Horizontal
R23: 12k1; R_Axial_DIN0207_L6.3mm_D2.5mm_P10.16mm_Horizontal
R24: 2k70; R_Axial_DIN0207_L6.3mm_D2.5mm_P10.16mm_Horizontal
R49: 1k5; not fitted
R50: 2k2; not fitted
U2: LM2901; DIP-14_W7.62mm

Connections:
+5V: JP1.1 (A), R5.2, R17.2
+BATT: C13.2, R15.2, R49.2, U2.6 (-)
-BATT: R16.1
COMP_A+: C2.2, R20.1, U2.5 (+)
COMP_A-: C1.2, R11.1, R17.1, U2.4 (-)
COMP_B+: R22.2, R23.1, U2.7 (+)
COMP_B_OUT: U2.1
COMP_C-: R12.1, R14.1, U2.10 (-)
COMP_D+: R13.1, R14.2, R15.1, U2.9 (+)
COMP_D_OUT: D12.2 (A), JP11.2 (B), R49.1, R50.1, U2.14
CON_3_TPG: K1.2 (N1)
CON_6_TPT: K1.7 (COM)
GND: C1.1, C2.1, D2.2 (A), Q1.3 (E), R12.2, R22.1, U2.12 (V-)
MC_3: C13.1, D12.1 (K), JP11.1 (A), R13.2, R50.2
MC_4: U2.13
MC_35: U2.2
MC_39: Q1.2 (B)
unnamed: D1.1 (K), R10.2, R20.2
unnamed: D1.2 (A), D11.2 (A), K1.12 (COIL_1), Q1.1 (C)
unnamed: D2.1 (K), D3.1 (K)
unnamed: D3.2 (A), JP6.2 (B), R6.1, R24.2
unnamed: JP1.2 (B), JP2.1 (A), R4.2, R5.1
unnamed: JP2.2 (B), JP3.1 (A), R3.2, R4.1
unnamed: JP3.2 (B), JP4.1 (A), R2.2, R3.1
unnamed: JP4.2 (B), JP5.1 (A), R1.2, R2.1
unnamed: JP5.2 (B), R1.1, R10.1
unnamed: JP6.1 (A), JP7.2 (B), R6.2, R7.1
unnamed: JP7.1 (A), JP8.2 (B), R7.2, R8.1
unnamed: JP8.1 (A), JP9.2 (B), R8.2, R9.1
unnamed: JP9.1 (A), R9.2, R23.2
unnamed: K1.1 (N0), R11.2
unnamed: R16.2, U2.8 (-), U2.11 (+)
VCC_T15: D11.1 (K), K1.11 (COIL_2)
VCC_T30: R24.1, U2.3 (V+)

Notes on the sheet:
LM2901 Channel B
JP6 and JP9 are shorted on my board
NOTE: Two US spec versions of this board had R49, R50, D12, and C13 provisions populated, and JP11 open. They did not have their own footprints, but rather were placed as pictured below.
R49
D12
Temperature Signal Relay
C13
R50
LM2901 Channels C and D
BMW_E30_VFL_SI_Board_Comparator_Circuit
JP1 is open, all the rest are shorted
LM2901 Channels A and B
LM2901 Channel A
These provisions were likely added to improve the charging circuit by providing a more stable voltage input to the SAF1093 chip. By doing this it can more accurately and precisely monitor the charge status of the batteries. This signal is likely used to control Q2 on page 1 to connect the negative 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
When coil is not energized: N1 connected to COM, TMP Transmitter to Gauge
