Ansel84/BMW_E30_SI_Board/KiCad Projects/BMW E30 VFL SI Board V2/BMW_E30_VFL_SI_Board_Indicator_Lights.kicad_sch

## KiCad design KiCad Projects/BMW E30 VFL SI Board V2/BMW_E30_VFL_SI_Board_Indicator_Lights.kicad_sch (2025-11-11)

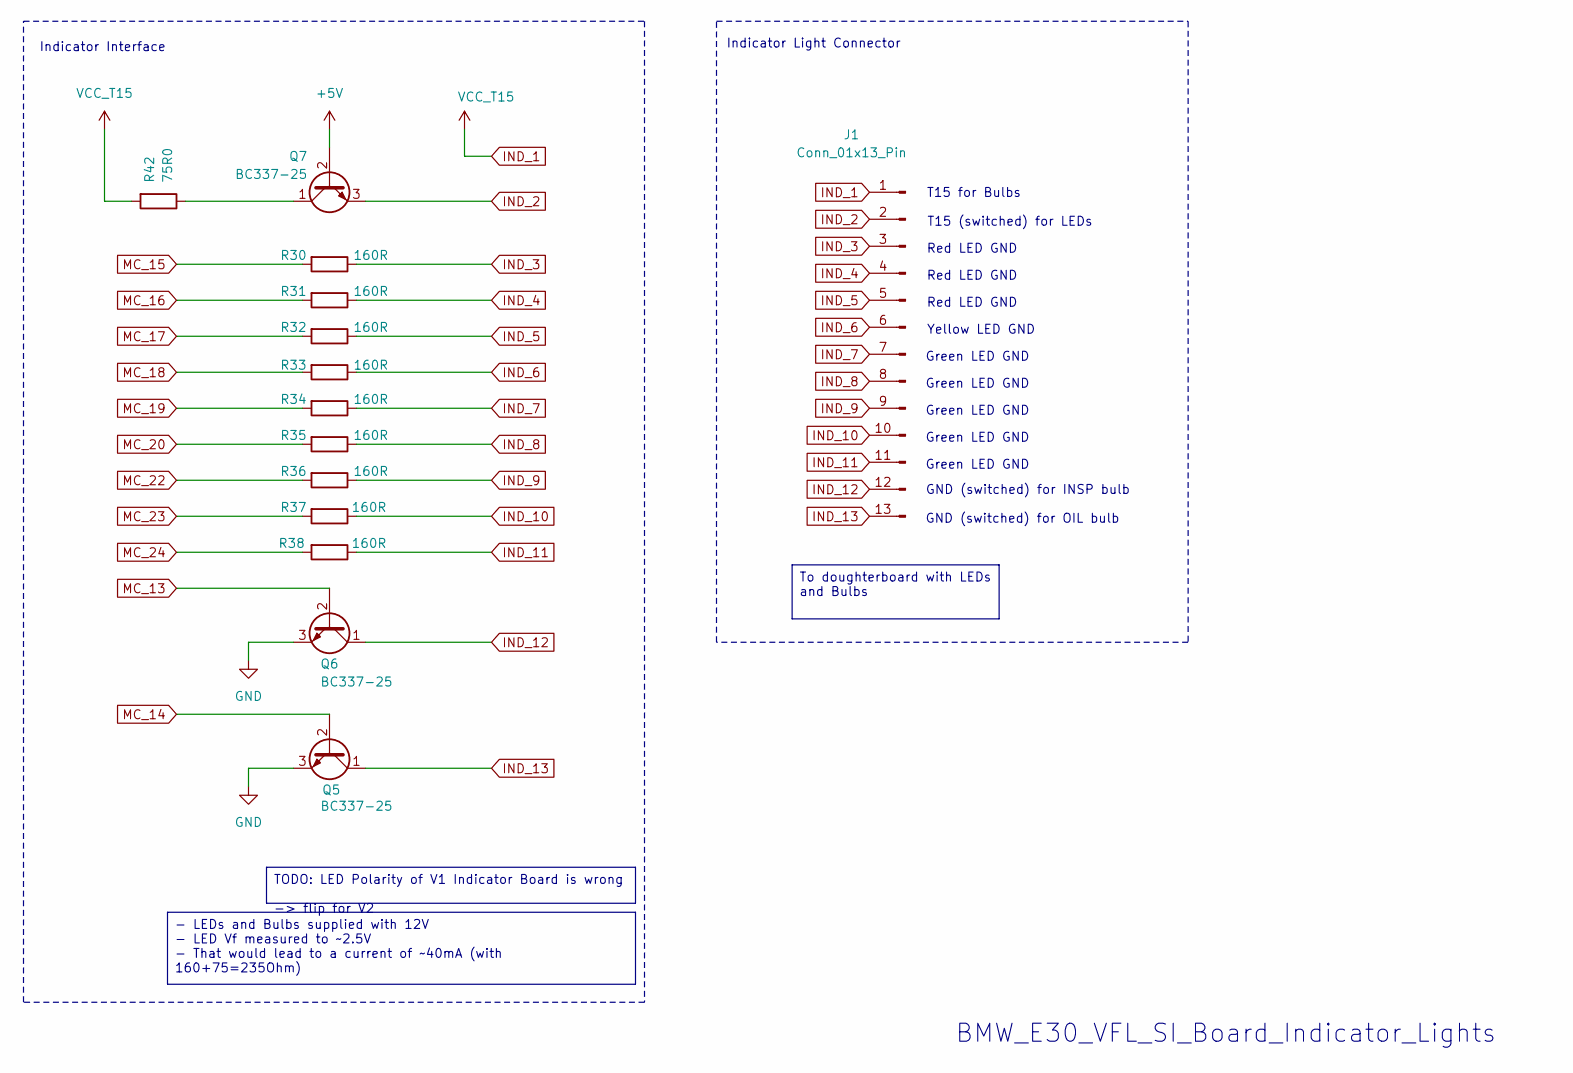
[picture p13: schematic BMW_E30_VFL_SI_Board_Indicator_Lights.kicad_sch]

Parts:
J1: Conn_01x13_Pin; PinHeader_1x13_P2.54mm_Vertical
Q5, Q6, Q7: BC337-25; TO-92_Inline_Wide
R30, R31, R32, R33, R34, R35: 160R; R_Axial_DIN0207_L6.3mm_D2.5mm_P10.16mm_Horizontal
R36, R37, R38: 160R; R_Axial_DIN0207_L6.3mm_D2.5mm_P15.24mm_Horizontal
R42: 75R0; R_Axial_DIN0309_L9.0mm_D3.2mm_P15.24mm_Horizontal

Connections:
+5V: Q7.2 (B)
GND: Q5.3 (E), Q6.3 (E)
IND_1: J1.1 (GND_BULB), R42.2
IND_2: J1.2 (GND_LED), Q7.3 (E)
IND_3: J1.3 (LED_R3), R30.1
IND_4: J1.4 (LED_R2), R31.1
IND_5: J1.5 (LED_R1), R32.1
IND_6: J1.6 (LED_Y), R33.1
IND_7: J1.7 (LED_G5), R34.1
IND_8: J1.8 (LED_G4), R35.1
IND_9: J1.9 (LED_G3), R36.1
IND_10: J1.10 (LED_G2), R37.1
IND_11: J1.11 (LED_G1), R38.1
IND_12: J1.12 (BULB_INSPECTION), Q6.1 (C)
IND_13: J1.13 (BULB_OILSERVICE), Q5.1 (C)
MC_13: Q6.2 (B)
MC_14: Q5.2 (B)
MC_15: R30.2
MC_16: R31.2
MC_17: R32.2
MC_18: R33.2
MC_19: R34.2
MC_20: R35.2
MC_22: R36.2
MC_23: R37.2
MC_24: R38.2
unnamed: Q7.1 (C), R42.1

Notes on the sheet:
Indicator Interface
Indicator Light Connector
GND (switched) for INSP bulb
Green LED GND
GND (switched) for OIL bulb
BMW_E30_VFL_SI_Board_Indicator_Lights
Red LED GND
Yellow LED GND
T15 (switched) for LEDs
T15 for Bulbs
TODO: LED Polarity of V1 Indicator Board is wrong -> flip for V2
To doughterboard with LEDs and Bulbs
- LEDs and Bulbs supplied with 12V - LED Vf measured to ~2.5V - That would lead to a current of ~40mA (with 160+75=235Ohm)
