Ansel84/BMW_E30_SI_Board/KiCad Projects/BMW E30 VFL SI Board V2/BMW_E30_VFL_SI_Board_Pad_Wear_Indicator.kicad_sch

## KiCad design KiCad Projects/BMW E30 VFL SI Board V2/BMW_E30_VFL_SI_Board_Pad_Wear_Indicator.kicad_sch (2025-11-11)

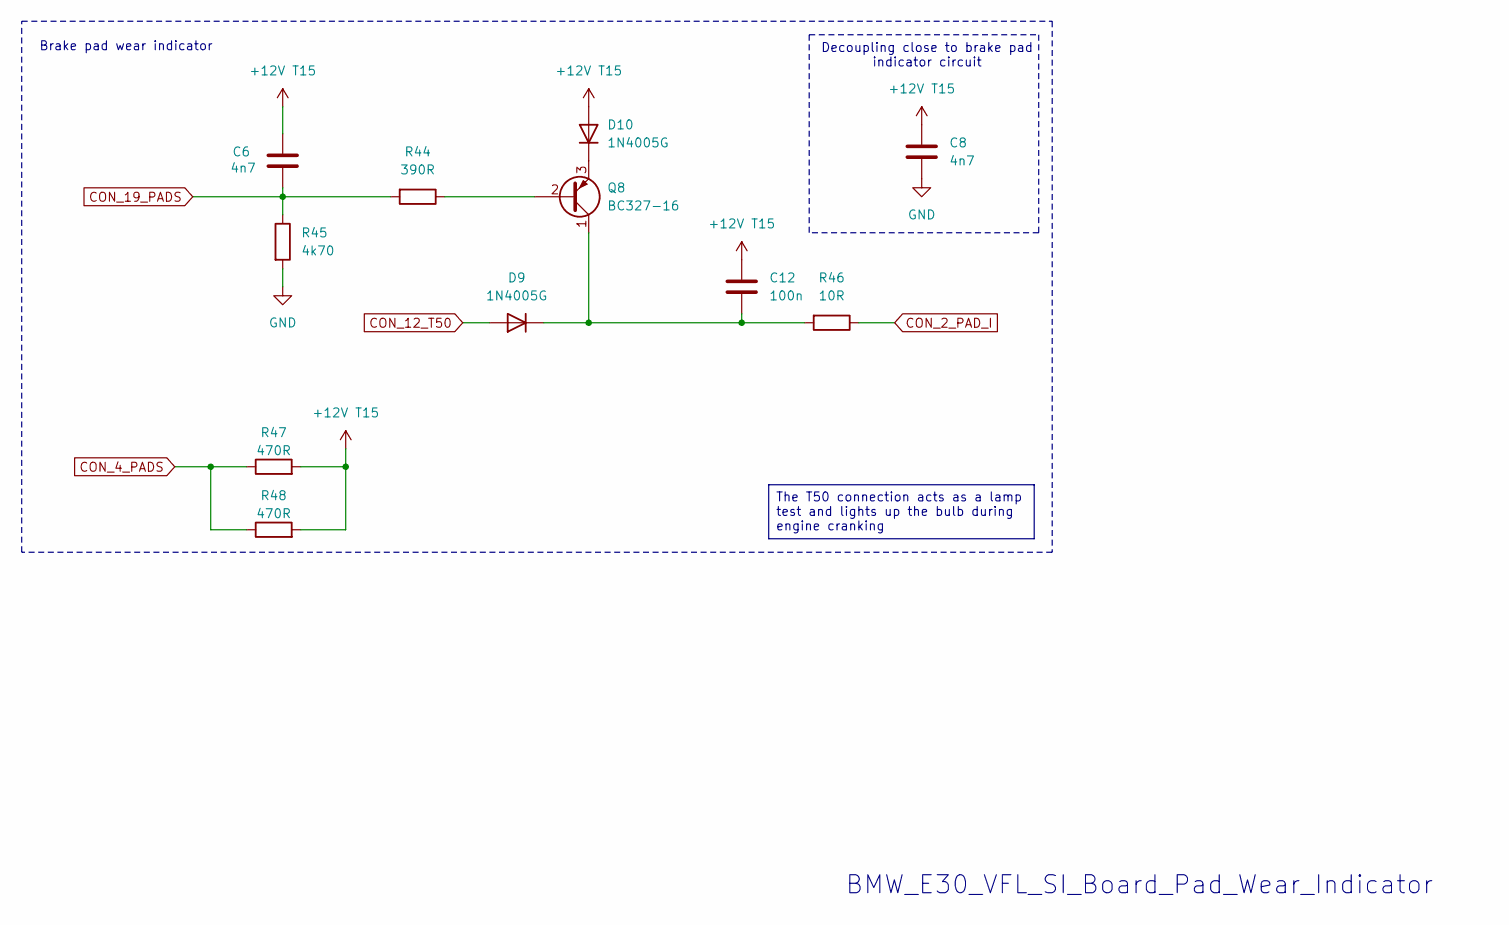
[picture p14: schematic BMW_E30_VFL_SI_Board_Pad_Wear_Indicator.kicad_sch]

Parts:
C6: 4n7; C_Disc_D8.0mm_W2.5mm_P5.00mm
C8: 4n7; C_Rect_L7.0mm_W2.5mm_P5.00mm
C12: 100n; C_Disc_D8.0mm_W2.5mm_P5.00mm
D9, D10: 1N4005G; D_DO-41_SOD81_P12.70mm_Horizontal
Q8: BC327-16; TO-92_Inline_Wide
R44: 390R; R_Axial_DIN0309_L9.0mm_D3.2mm_P15.24mm_Horizontal
R45: 4k70; R_Axial_DIN0207_L6.3mm_D2.5mm_P10.16mm_Horizontal
R46: 10R; R_Axial_DIN0207_L6.3mm_D2.5mm_P10.16mm_Horizontal
R47, R48: 470R; R_Axial_DIN0309_L9.0mm_D3.2mm_P15.24mm_Horizontal

Connections:
+12V T15: C6.2, C8.1, C12.2, D10.2 (A), R47.2, R48.2
CON_2_PAD_I: R46.1
CON_4_PADS: R47.1, R48.1
CON_12_T50: D9.2 (A)
CON_19_PADS: C6.1, R44.2, R45.1
GND: C8.2, R45.2
unnamed: C12.1, D9.1 (K), Q8.1 (C), R46.2
unnamed: D10.1 (K), Q8.3 (E)
unnamed: Q8.2 (B), R44.1

Notes on the sheet:
BMW_E30_VFL_SI_Board_Pad_Wear_Indicator
Brake pad wear indicator
Decoupling close to brake pad indicator circuit
The T50 connection acts as a lamp test and lights up the bulb during engine cranking
