Ansel84/BMW_E30_SI_Board/(commit log)

2025-08-10 V2 Board Updates
    Added in extra resistors, cap, and diode that were added to a particular version of the SI board from the USDM on the comparator circuit. Updated the schematic diagram of the comparator circuit to improve readability. Updated the clock frequency measured with a scope. Made a few minor layout improvements including moving the "JP" connections inwards as not to interfere with the plastic housing for the PCB in the cluster and other minor layout errors such as swapped reference designators. Updated info on where the +5V regulator gets its source voltage from. These updates are reflected in schematic version V2.1 as denoted in the title box (not in the title of the schematic fi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
    [BMW E30 VFL SI Board V2.kicad_sch, BMW_E30_VFL_SI_Board_Comparator_Circuit.kicad_sch, BMW_E30_VFL_SI_Board_Indicator_Lights.kicad_sch, BMW_E30_VFL_SI_Board_Instrument_Cluster.kicad_sch, BMW_E30_VFL_SI_Board_Pad_Wear_Indicator.kicad_sch]
2025-08-10 Silkscreen Updates
2025-08-10 Footprint Change
    Changed battery enable jumper footprint to a THT to make changing the connection easier.
    [BMW E30 VFL SI Board V2.kicad_sch]
2025-08-10 Updated Schematic PDF
2025-11-11 Update Name of SAF chip
    SAF1093 chip number added.
    [BMW E30 VFL SI Board V2.kicad_sch, BMW_E30_VFL_SI_Board_Comparator_Circuit.kicad_sch, BMW_E30_VFL_SI_Board_Indicator_Lights.kicad_sch, BMW_E30_VFL_SI_Board_Instrument_Cluster.kicad_sch, BMW_E30_VFL_SI_Board_Pad_Wear_Indicator.kicad_sch]
2025-11-27 Completed Schematic + Layout for SI LED
    Additional labels were added to the SI board schematic to denote which pin controls which light on the LED board.
2025-11-27 Revert "Completed Schematic + Layout for SI LED"
    This reverts commit eca5ce731d6ba06ffc0dce7e13951d5f891597bb.
